mataanabucar/EXV-rev-7/2026-09-24-EX-MA-simplified/2026-09-24-cut-list.md

# EX-MA control box, pedestal and sandbox — cut list

All parts 12 mm plywood (1/2in also works; hole positions are measured from the panel's lower-left corner as seen from the named side). Sizes in mm, rounded to 0.5.

## control-box

| Part | Qty | Length × width × thick | Notes |
|---|---|---|---|
| box floor | 1 | 405.0 × 250.0 × 12.0 |  |
| box front | 1 | 405.0 × 218.0 × 12.0 |  |
| box rear | 1 | 405.0 × 218.0 × 12.0 |  |
| box right side | 1 | 226.0 × 218.0 × 12.0 |  |
| box left side | 1 | 226.0 × 218.0 × 12.0 |  |
| box top (removable) | 1 | 405.0 × 250.0 × 12.0 | screwed to the sides, front and rear; lift off for service |
| axle bearing block left | 1 | 100.0 × 60.0 × 12.0 | screwed to the floor from below (2 x #6) |
| axle bearing block right | 1 | 100.0 × 60.0 × 12.0 | screwed to the floor from below (2 x #6) |

**box floor** — holes / slots

| Feature | Size | Position (a, b) | Purpose |
|---|---|---|---|
| hole | Ø8.5 | (113.0, 100.0) along (u, v) | slew spool axle (nut + washer in a Ø22 x 7 counterbore from below) |

**box front** — holes / slots

| Feature | Size | Position (a, b) | Purpose |
|---|---|---|---|
| hole | Ø62.0 | (282.0, 80.0) along (v, z) | 2in conduit |
| hole | Ø4.6 | (322.0, 40.0) along (v, z) | fitting bolt (M3 × 35 through the sandbox wall) |
| hole | Ø4.6 | (322.0, 120.0) along (v, z) | fitting bolt (M3 × 35 through the sandbox wall) |
| hole | Ø4.6 | (242.0, 40.0) along (v, z) | fitting bolt (M3 × 35 through the sandbox wall) |
| hole | Ø4.6 | (242.0, 120.0) along (v, z) | fitting bolt (M3 × 35 through the sandbox wall) |
| hole | Ø4.6 | (25.0, 25.0) along (v, z) | box-to-sandbox bolt (M3 × 30) |
| hole | Ø4.6 | (380.0, 25.0) along (v, z) | box-to-sandbox bolt (M3 × 30) |

**box top (removable)** — holes / slots

| Feature | Size | Position (a, b) | Purpose |
|---|---|---|---|
| hole | Ø24.4 | (113.0, 100.0) along (u, v) | spool tube bearing |
| slot | 133.0 × 9.0 slot (along u) | (93.0, 360.0) along (u, v) | boom lever slot = hard stop (42 deg swing) |
| slot | 128.7 × 9.0 slot (along u) | (93.0, 290.0) along (u, v) | stick lever slot = hard stop (41 deg swing) |
| slot | 123.9 × 9.0 slot (along u) | (93.0, 220.0) along (u, v) | bucket lever slot = hard stop (40 deg swing) |

**axle bearing block left** — holes / slots

| Feature | Size | Position (a, b) | Purpose |
|---|---|---|---|
| hole | Ø8.5 | (30.0, 70.0) along (u, z) | 5/16in lever axle |

**axle bearing block right** — holes / slots

| Feature | Size | Position (a, b) | Purpose |
|---|---|---|---|
| hole | Ø8.5 | (30.0, 70.0) along (u, z) | 5/16in lever axle |

## pedestal

| Part | Qty | Length × width × thick | Notes |
|---|---|---|---|
| pedestal top | 1 | 200.0 × 180.0 × 12.0 |  |
| pedestal wall -u (conduit) | 1 | 180.0 × 178.0 × 12.0 |  |
| pedestal wall +u (removable access) | 1 | 180.0 × 178.0 × 12.0 | screwed on; remove to reach the slew drum clamp and the elbow |
| pedestal wall -v | 1 | 178.0 × 176.0 × 12.0 |  |
| pedestal wall +v | 1 | 178.0 × 176.0 × 12.0 |  |
| pedestal shelf | 1 | 156.0 × 148.0 × 12.0 | rests on the two cleats; carries the PEX bushing just above the slew drum |
| pedestal shelf cleat -v | 1 | 148.0 × 12.0 × 12.0 |  |
| pedestal shelf cleat +v | 1 | 148.0 × 12.0 × 12.0 |  |

**pedestal top** — holes / slots

| Feature | Size | Position (a, b) | Purpose |
|---|---|---|---|
| hole | Ø26.2 | (110.0, 90.0) along (u, v) | PEX turret tube clearance |
| hole | Ø3.0 | (136.9, 116.9) along (u, v) | pilot, #8 screw from the base |
| hole | Ø3.0 | (83.1, 116.9) along (u, v) | pilot, #8 screw from the base |
| hole | Ø3.0 | (83.1, 63.1) along (u, v) | pilot, #8 screw from the base |
| hole | Ø3.0 | (136.9, 63.1) along (u, v) | pilot, #8 screw from the base |

**pedestal wall -u (conduit)** — holes / slots

| Feature | Size | Position (a, b) | Purpose |
|---|---|---|---|
| hole | Ø62.0 | (82.0, 80.0) along (v, z) | 2in conduit |
| hole | Ø4.6 | (42.0, 40.0) along (v, z) | fitting bolt (M3 × 25) |
| hole | Ø4.6 | (42.0, 120.0) along (v, z) | fitting bolt (M3 × 25) |
| hole | Ø4.6 | (122.0, 40.0) along (v, z) | fitting bolt (M3 × 25) |
| hole | Ø4.6 | (122.0, 120.0) along (v, z) | fitting bolt (M3 × 25) |

**pedestal shelf** — holes / slots

| Feature | Size | Position (a, b) | Purpose |
|---|---|---|---|
| hole | Ø30.4 | (70.0, 78.0) along (u, v) | slew-tube-bushing |

## sandbox

| Part | Qty | Length × width × thick | Notes |
|---|---|---|---|
| sandbox floor | 1 | 610.0 × 610.0 × 12.0 | the pedestal and the elbow support screw to it |
| sandbox wall -u (box side) | 1 | 610.0 × 230.0 × 12.0 |  |
| sandbox wall +u | 1 | 610.0 × 230.0 × 12.0 |  |
| sandbox wall -v | 1 | 586.0 × 230.0 × 12.0 |  |
| sandbox wall +v | 1 | 586.0 × 230.0 × 12.0 |  |

**sandbox wall -u (box side)** — holes / slots

| Feature | Size | Position (a, b) | Purpose |
|---|---|---|---|
| hole | Ø62.0 | (297.0, 80.0) along (v, z) | 2in conduit (seal with silicone) |
| hole | Ø4.6 | (337.0, 40.0) along (v, z) | bolt from the control box |
| hole | Ø4.6 | (337.0, 120.0) along (v, z) | bolt from the control box |
| hole | Ø4.6 | (257.0, 40.0) along (v, z) | bolt from the control box |
| hole | Ø4.6 | (257.0, 120.0) along (v, z) | bolt from the control box |
| hole | Ø4.6 | (40.0, 25.0) along (v, z) | bolt from the control box |
| hole | Ø4.6 | (395.0, 25.0) along (v, z) | bolt from the control box |

## Other cut stock

- 2in sch 40 PVC conduit: 141 mm (socket floor to socket floor).
- 5/16in rod: lever axle 205 mm; slew spool axle 274 mm.
- 5/16in rod lever handles: 3 × 230 mm.
- 8-32 rod (joint pins only): 2 × 42 mm, 2 × 22 mm, 1 × 65 mm.
