mataanabucar/EXV-rev-7/2026-09-24-EX-MA-simplified/Preview/2026-09-24-b5-control-box.png

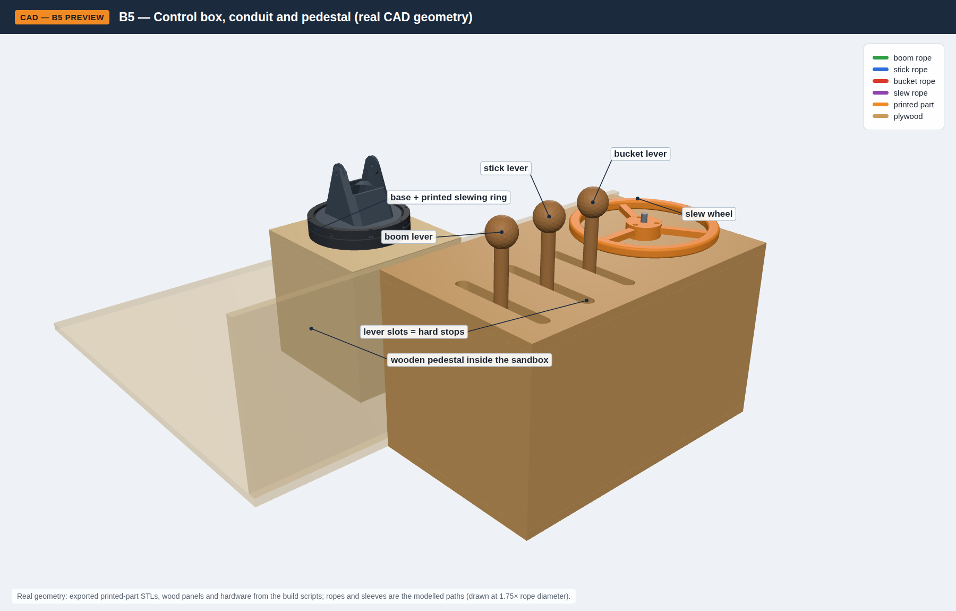
2026-09-24-EX-MA-simplified/Preview/2026-09-24-b5-control-box.png
