mataanabucar/EXV-rev-7/2026-09-24-EX-MA-simplified/Preview/2026-09-24-concept-05-arm-cutaway.png

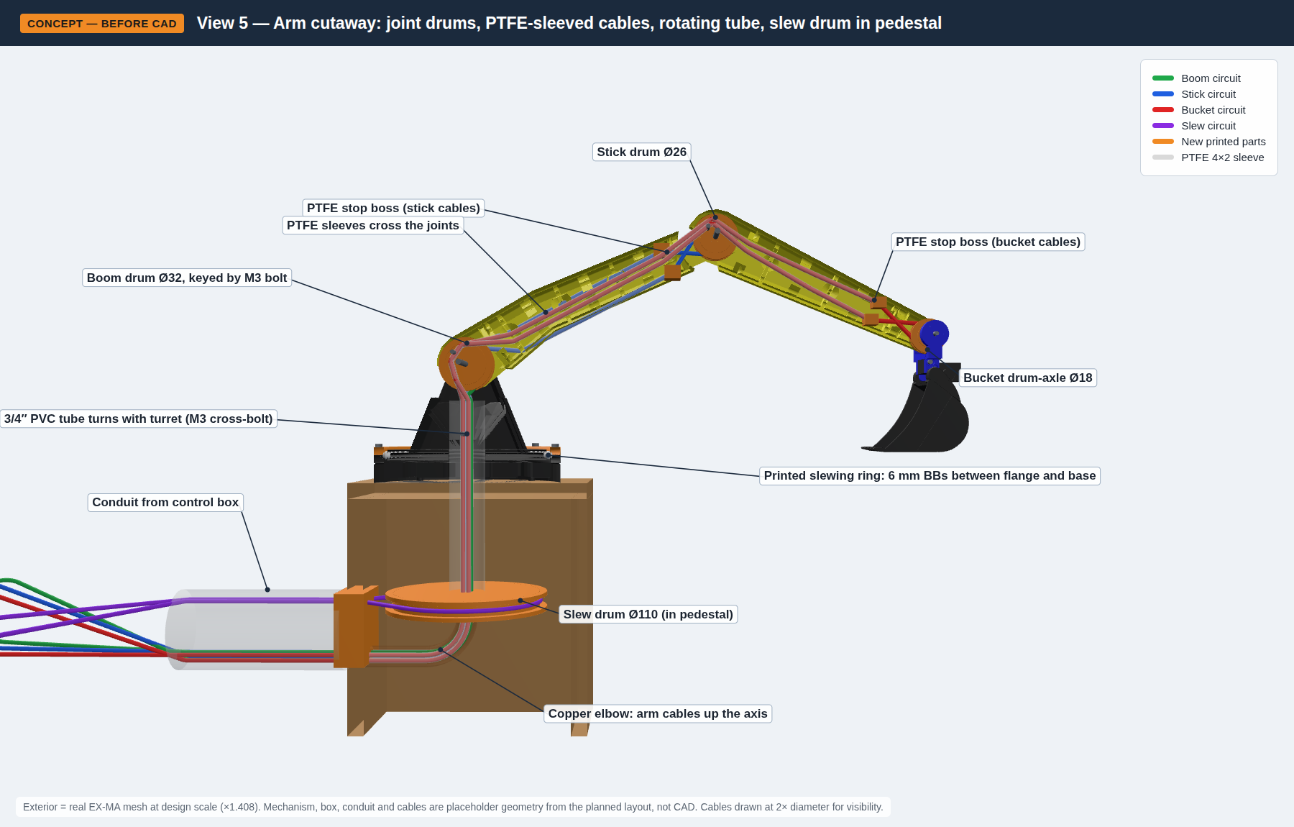
2026-09-24-EX-MA-simplified/Preview/2026-09-24-concept-05-arm-cutaway.png
