mataanabucar/EXV-rev-7/2026-09-24-EX-MA-simplified/Preview/2026-09-24-concept-06-slew-bearing-detail.png

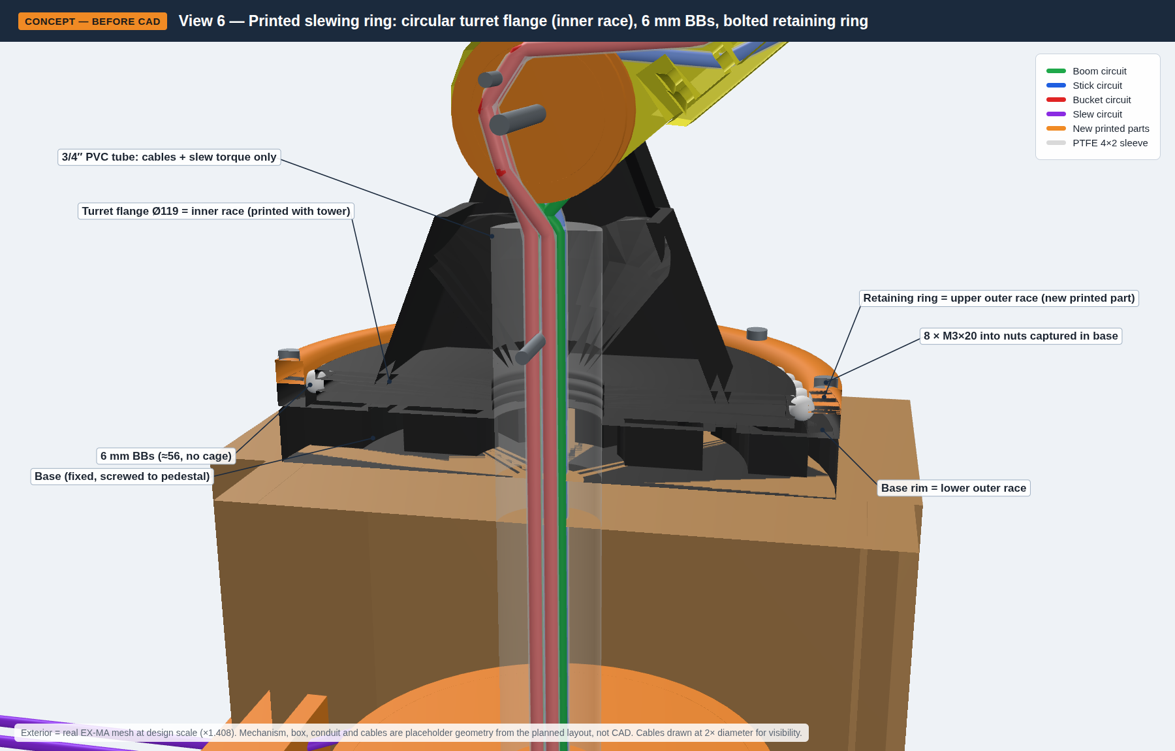
2026-09-24-EX-MA-simplified/Preview/2026-09-24-concept-06-slew-bearing-detail.png
