mataanabucar/EXV-rev-7/2026-09-24-EX-MA-simplified/Preview/2026-09-24-view2-full-system-cutaway.png

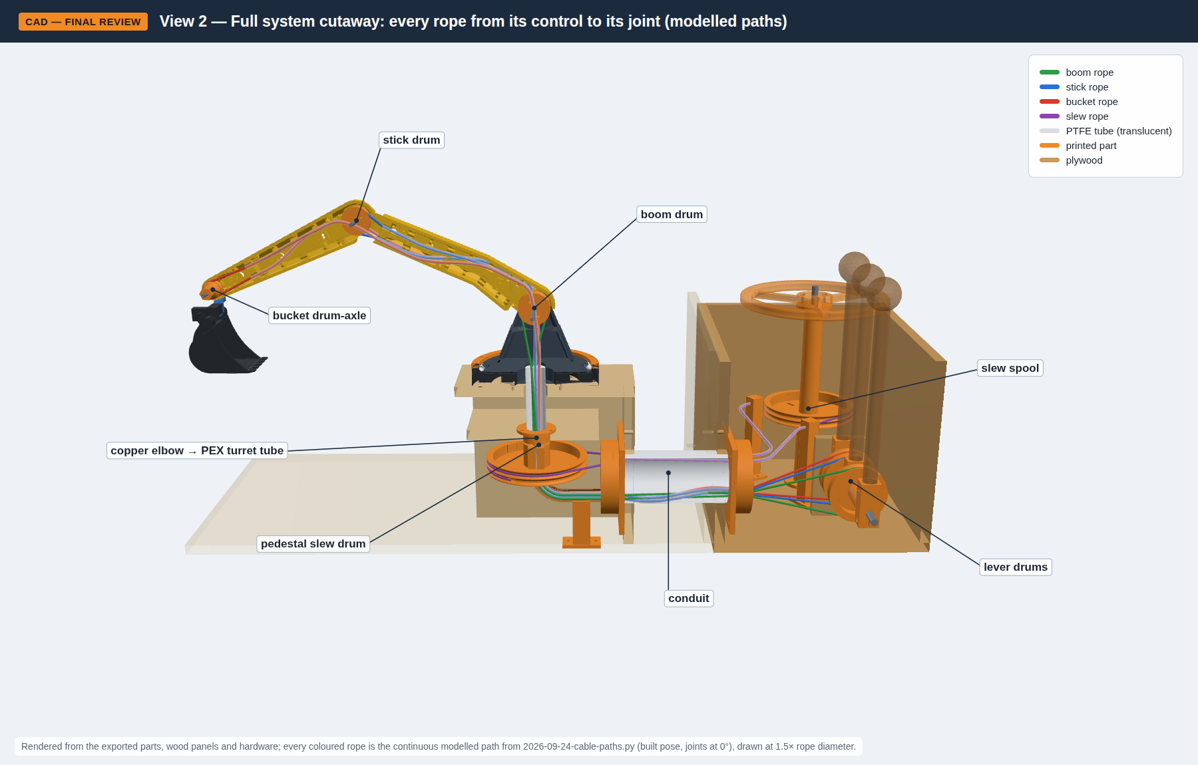
2026-09-24-EX-MA-simplified/Preview/2026-09-24-view2-full-system-cutaway.png
