mataanabucar/EXV-rev-7/2026-09-24-EX-MA-simplified/Preview/2026-09-24-view4-boom-joint.png

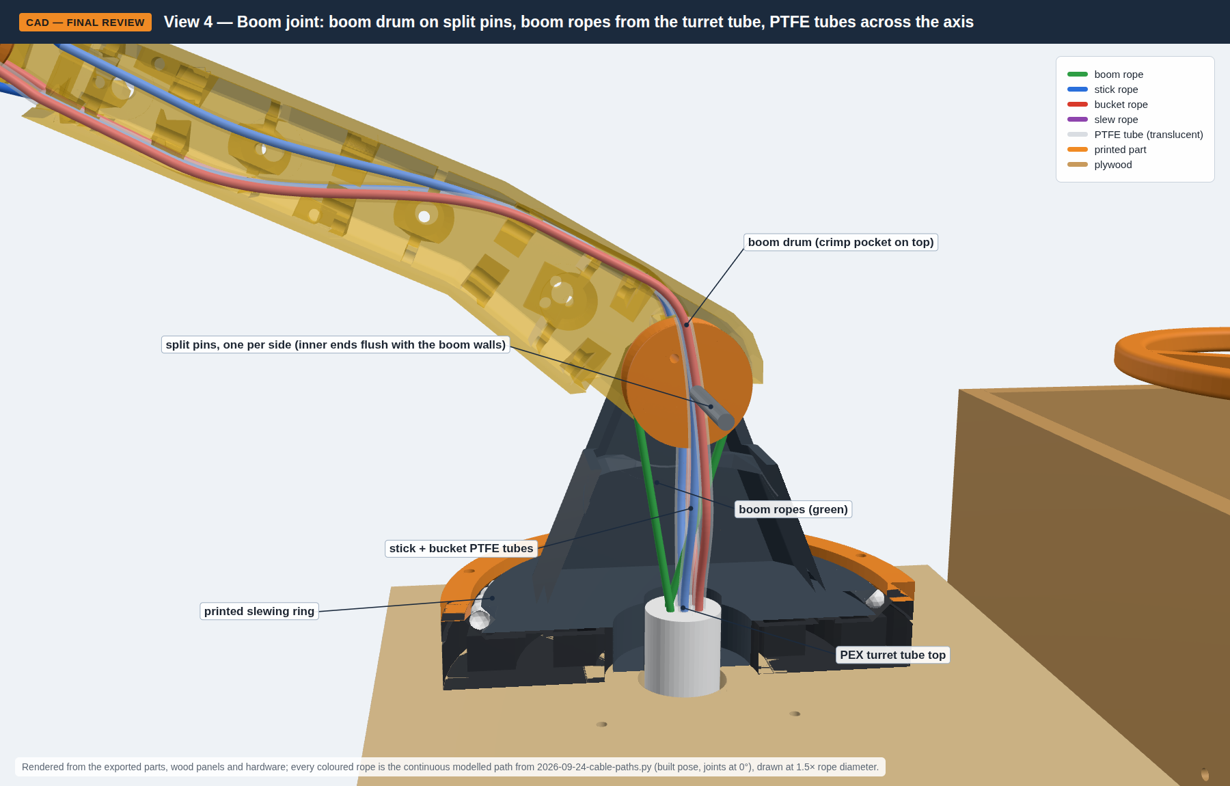
2026-09-24-EX-MA-simplified/Preview/2026-09-24-view4-boom-joint.png
