mataanabucar/EXV-rev-7/2026-09-24-EX-MA-simplified/Preview/2026-09-25-stick-nose-before-after.png

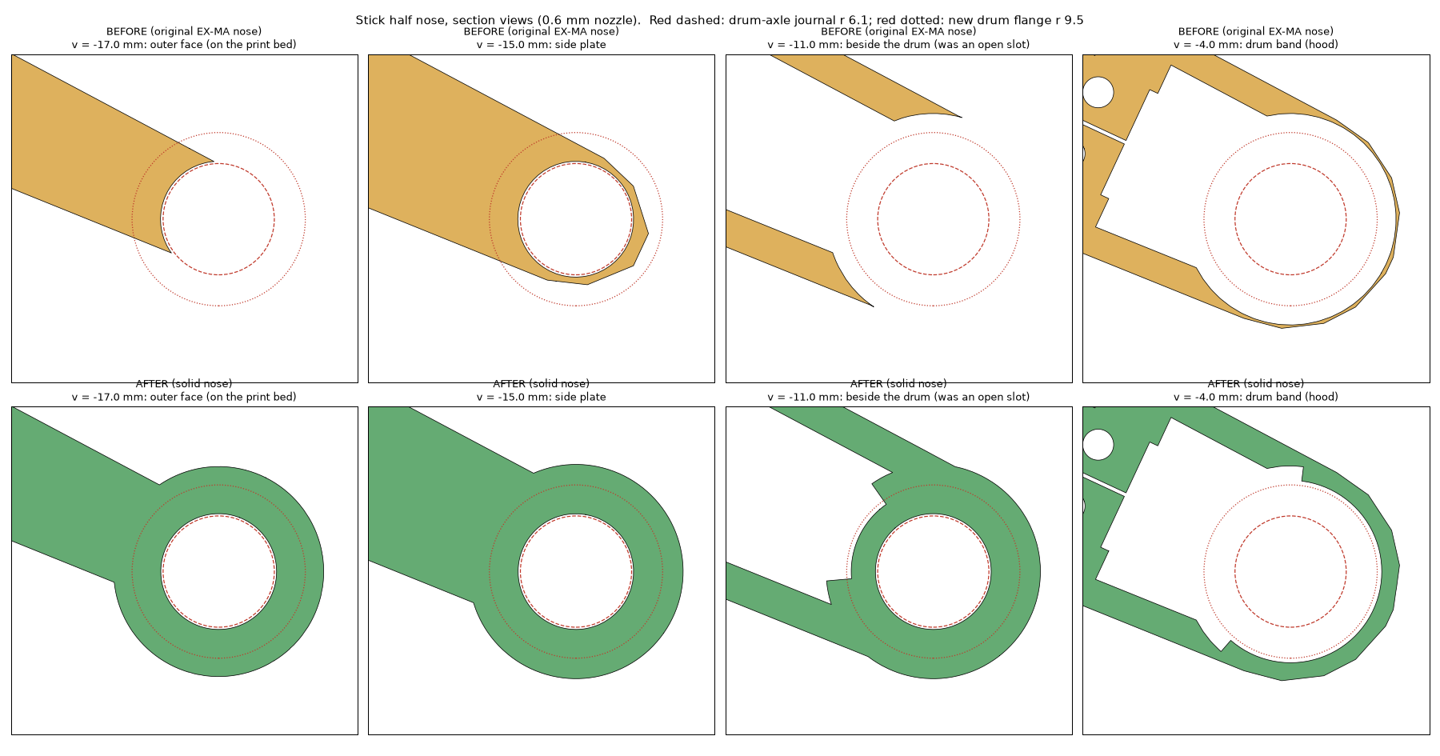
2026-09-24-EX-MA-simplified/Preview/2026-09-25-stick-nose-before-after.png
