mataanabucar/EXV-rev-7/References/ARM image.png

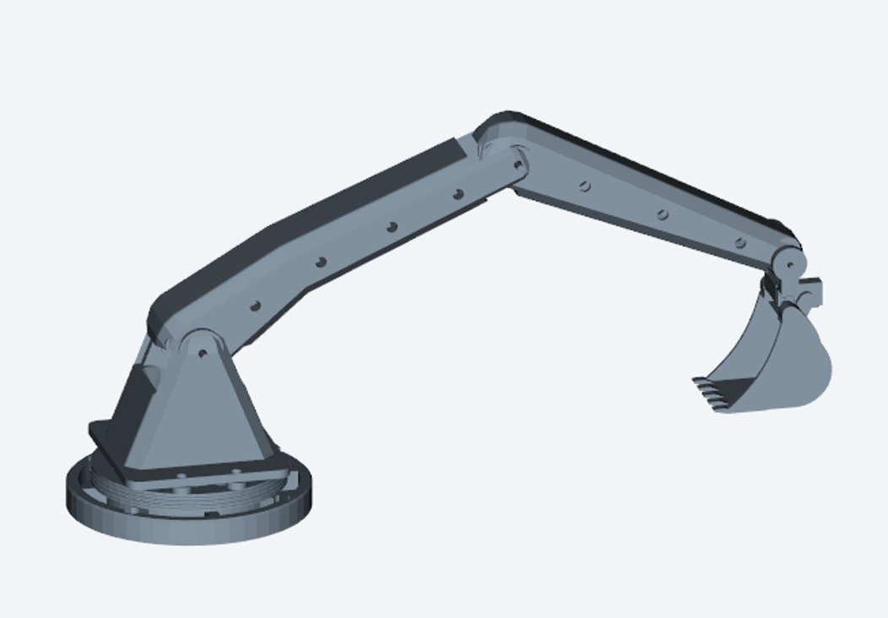
References/ARM image.png
