mataanabucar/EXV-rev-7/References/image-gen-2.png

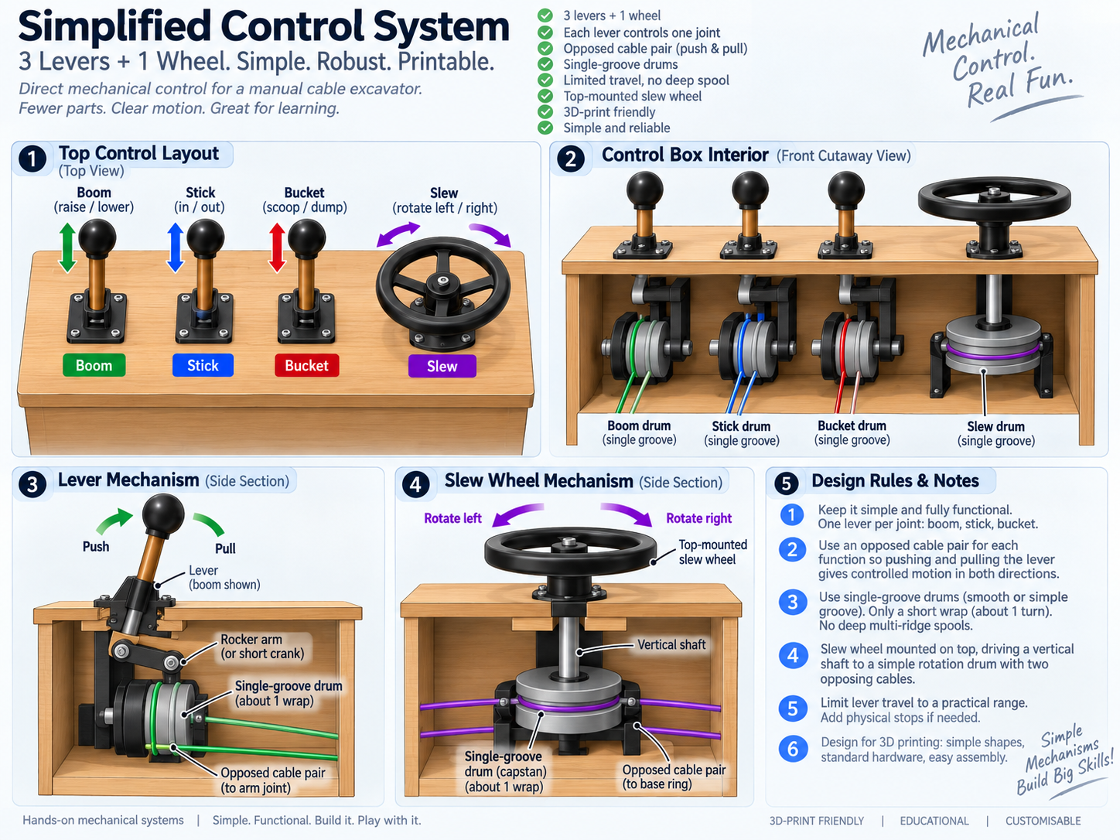
References/image-gen-2.png
