mataanabucar/EXV-rev-7/References/IMG_2449.jpeg

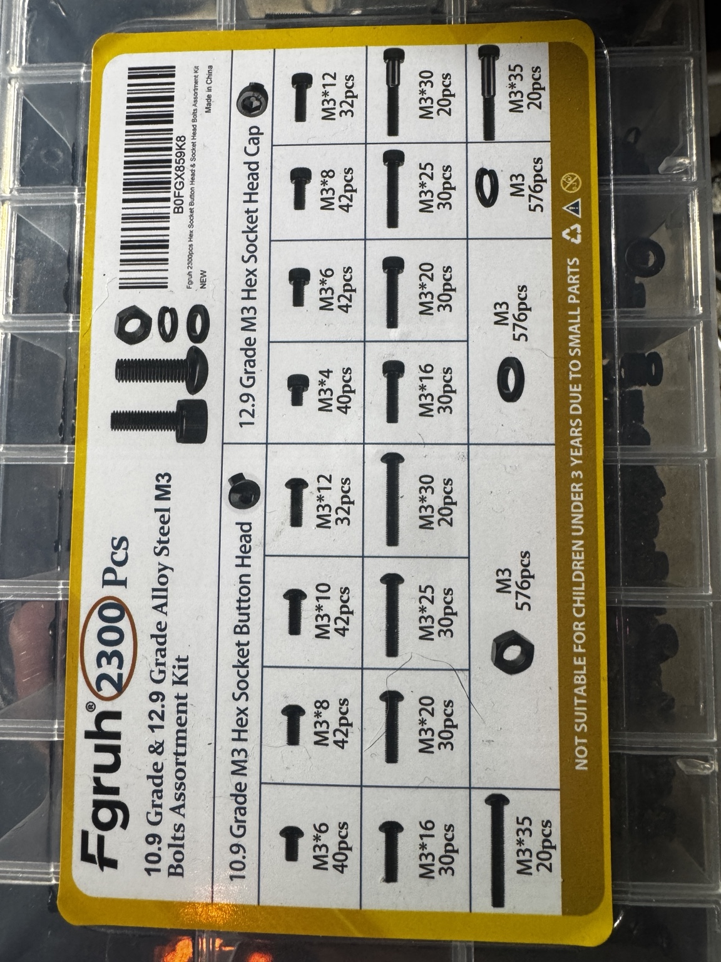
References/IMG_2449.jpeg
