mataanabucar/EXV-rev-7/References/IMG_2454.jpeg

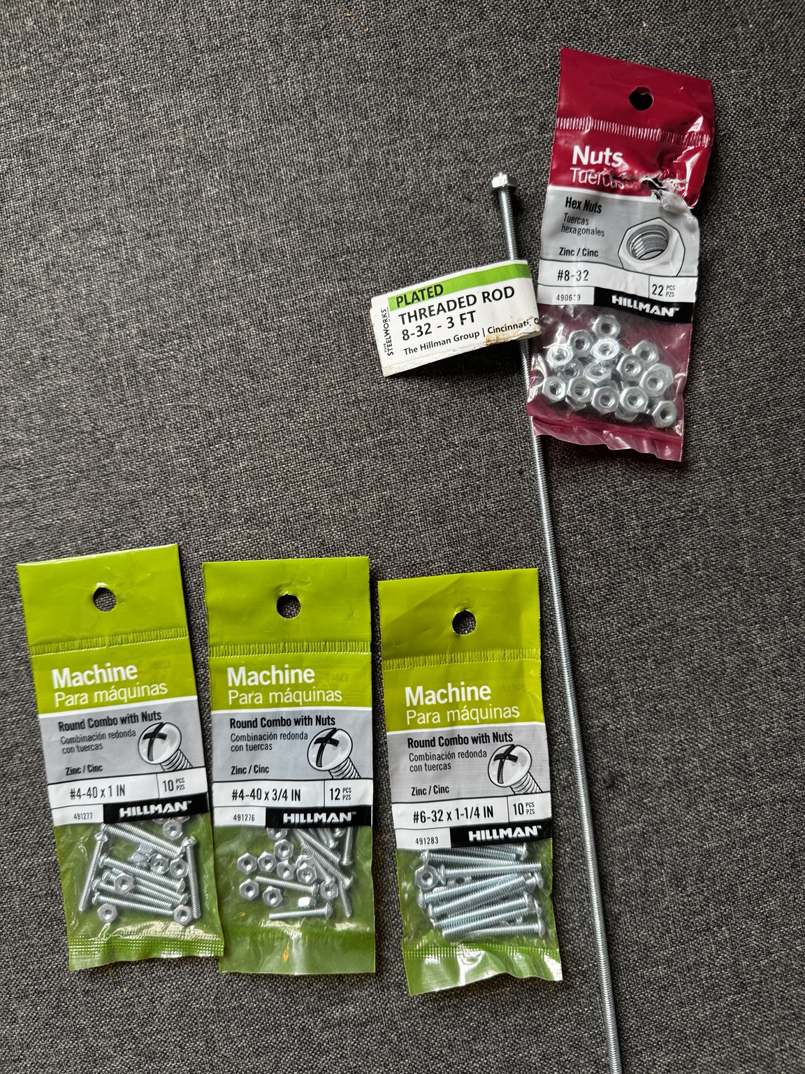
References/IMG_2454.jpeg
