mataanabucar/EXV-rev-7/References/ref image 3.png

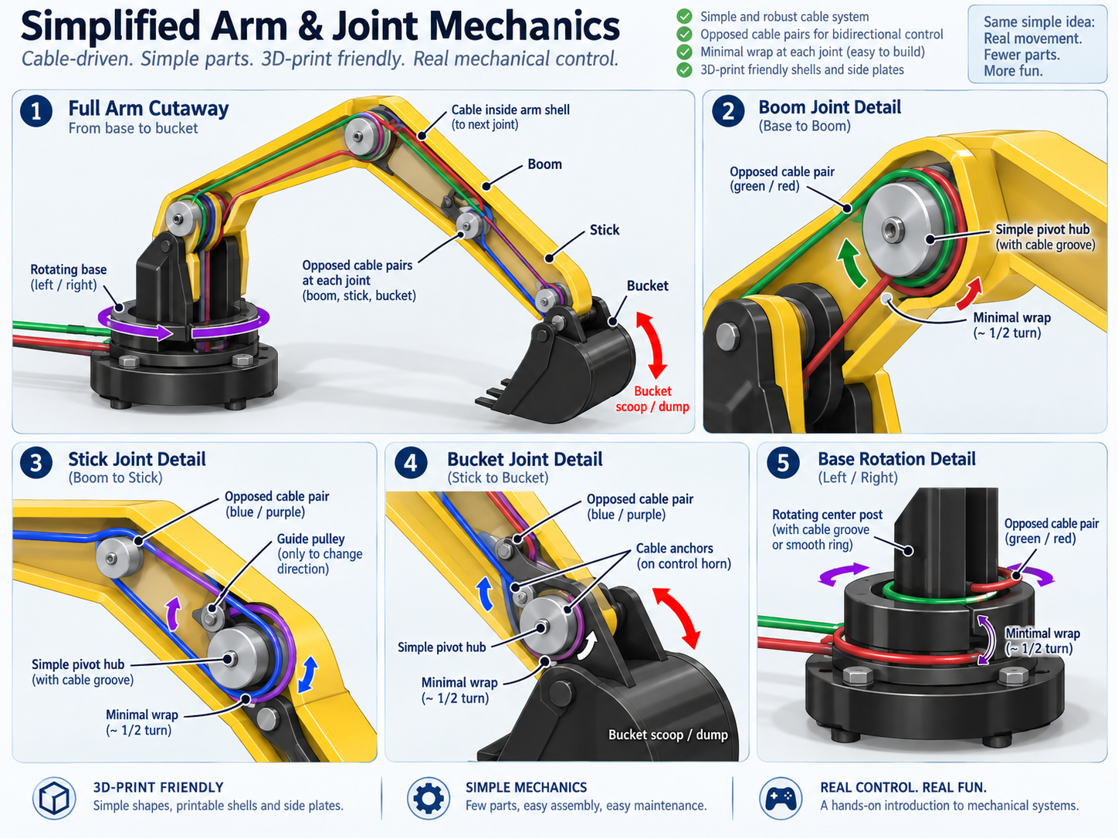
References/ref image 3.png
