mataanabucar/EXV-rev-7/References/ref image 4(1).png

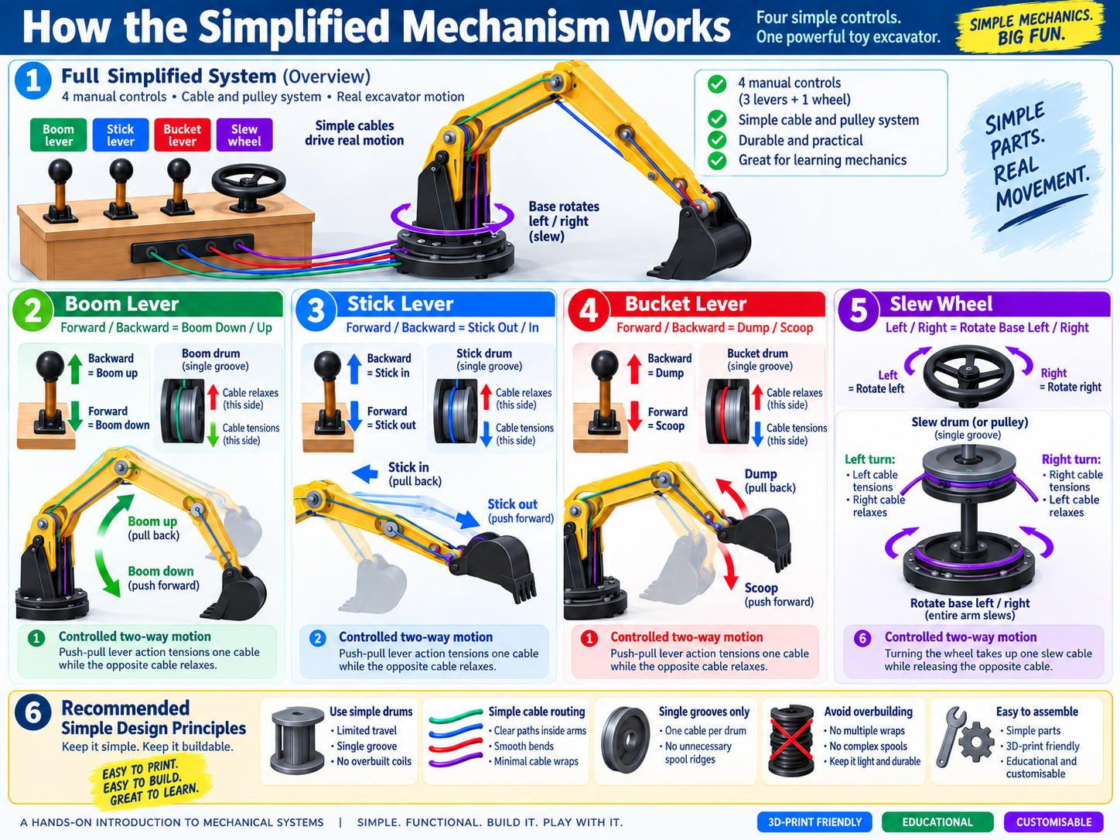
References/ref image 4(1).png
