mataanabucar/EXV-rev-7/References/ref image 5.png

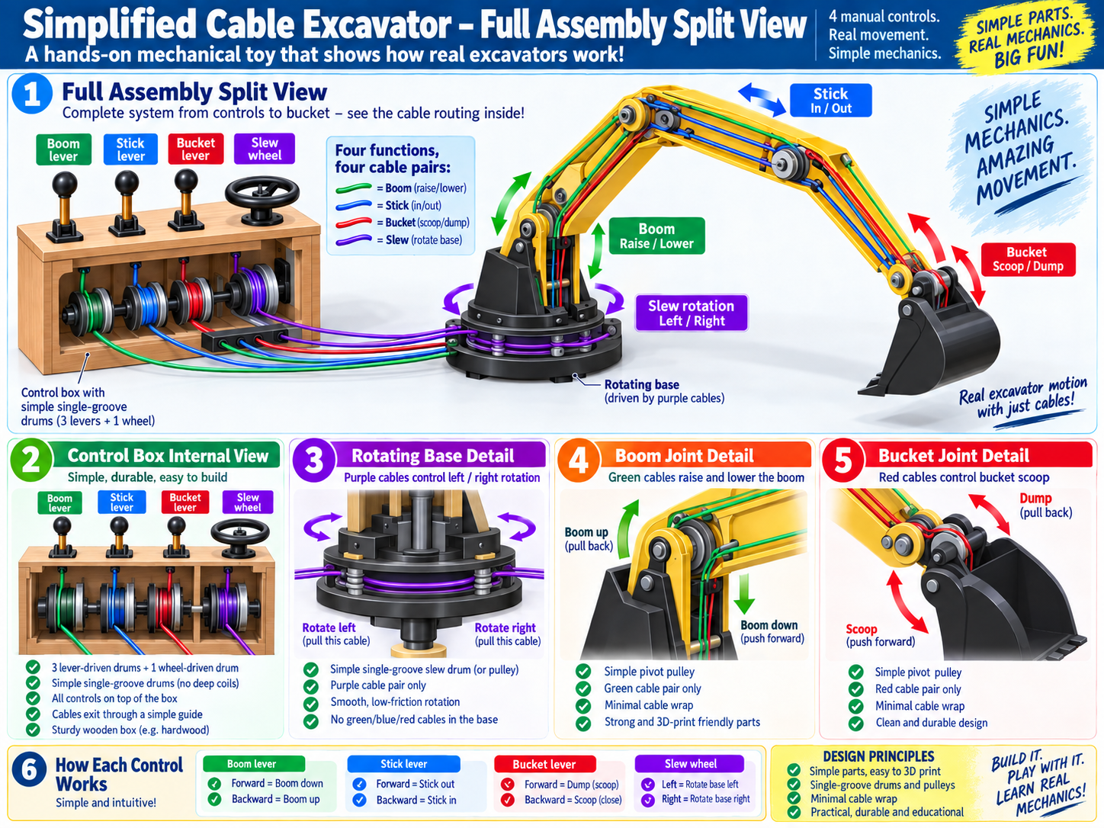
References/ref image 5.png
