mataanabucar/EXV-rev-7/2026-09-24-EX-MA-simplified/STEP/2026-09-24-ex-ma-assembly.step

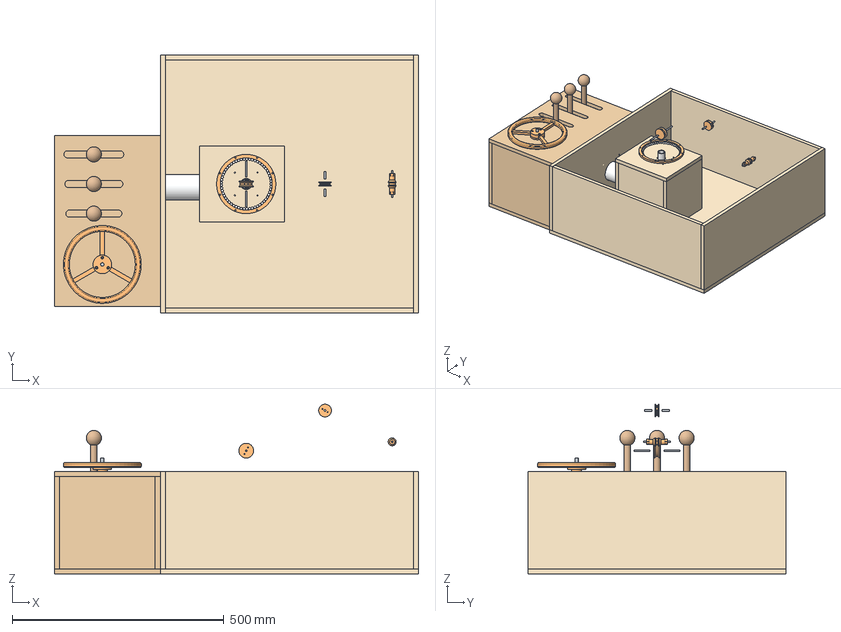
[picture p25: CAD file, 2026-09-25]
2026-09-24-EX-MA-simplified/STEP/2026-09-24-ex-ma-assembly.step
860.0 x 610.0 x 401.0 mm
boom-drum
stick-drum
bucket-drum-axle
slew-drum
slewing-ring-retaining-ring
conduit-end-fitting-box
conduit-end-fitting-pedestal
lever-hub-boom
lever-hub-stick
lever-hub-bucket
slew-spool
slew-wheel
spool-riser
slew-tube-post-A
slew-tube-post-B
slew-tube-bushing
elbow-support
box-floor
box-front
box-rear
box-right-side
box-left-side
box-top-removable
axle-bearing-block-left
axle-bearing-block-right
pedestal-top
pedestal-wall--u-conduit
pedestal-wall-+u-removable-access
pedestal-wall--v
pedestal-wall-+v
pedestal-shelf
pedestal-shelf-cleat--v
pedestal-shelf-cleat-+v
sandbox-floor
sandbox-wall--u-box-side
sandbox-wall-+u
sandbox-wall--v
sandbox-wall-+v
lever-axle-5_16in-rod
slew-spool-axle-5_16in-rod
boom-handle-(5_8in-dowel-+-knob)
stick-handle-(5_8in-dowel-+-knob)
bucket-handle-(5_8in-dowel-+-knob)
2in-PVC-conduit
3_4in-PEX-B-turret-tube
1_2in-copper-elbow-+-pipe
boom-split-pin-left-(8-32-rod)
boom-split-pin-right-(8-32-rod)
stick-split-pin-left-(8-32-rod)
stick-split-pin-right-(8-32-rod)
bucket-pin-(8-32-rod)
BB-01
BB-02
BB-03
BB-04
BB-05
BB-06
BB-07
BB-08
BB-09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
