mataanabucar/EXV-rev-7/2026-09-24-EX-MA-simplified/3MF/2026-09-27-orca-other-parts-plaplus.3mf

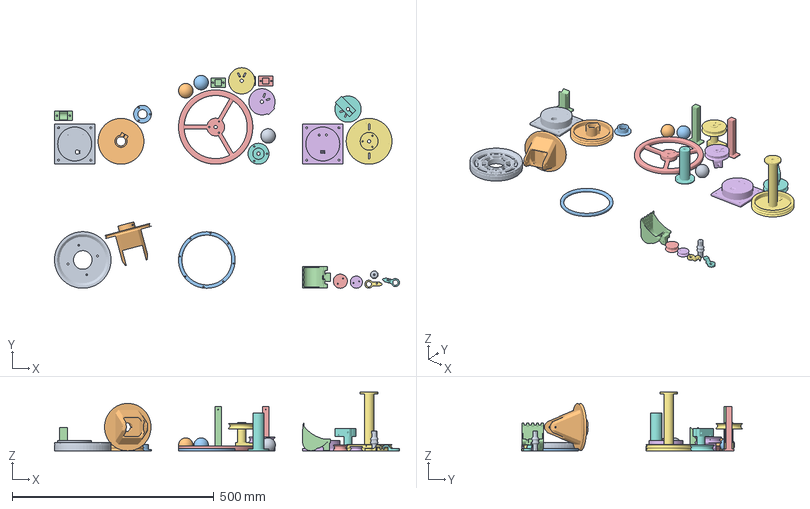
[picture p26: CAD file, 2026-09-28]
2026-09-24-EX-MA-simplified/3MF/2026-09-27-orca-other-parts-plaplus.3mf
854.3 x 546.1 x 145.0 mm
conduit-end-fitting-pedestal
slew-drum
slew-tube-bushing
elbow-support
slew-wheel
lever-hub-stick
lever-hub-boom
spool-riser
lever-knob-1
lever-knob-2
lever-knob-3
slew-tube-post-1
slew-tube-post-2
conduit-end-fitting-box
slew-spool
lever-hub-bucket
base
tower
slewing-ring-retaining-ring
bucket
boom-drum
stick-drum
bucket-ear-right
bucket-ear-left
bucket-drum-axle
