mataanabucar/EXV-rev-7/2026-09-24-EX-MA-simplified/STEP/2026-09-29-bucket-ear-left-cad.step

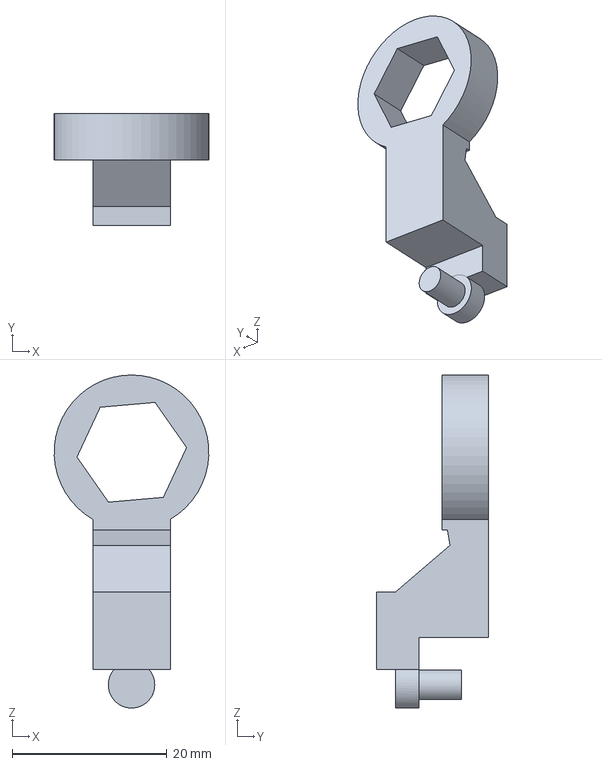
[picture p27: CAD file, 2026-09-29]
2026-09-24-EX-MA-simplified/STEP/2026-09-29-bucket-ear-left-cad.step
19.9 x 14.5 x 43.0 mm
