mataanabucar/EXV-rev-7/2026-09-24-EX-MA-simplified/STL/2026-09-24-boom-half-left.stl

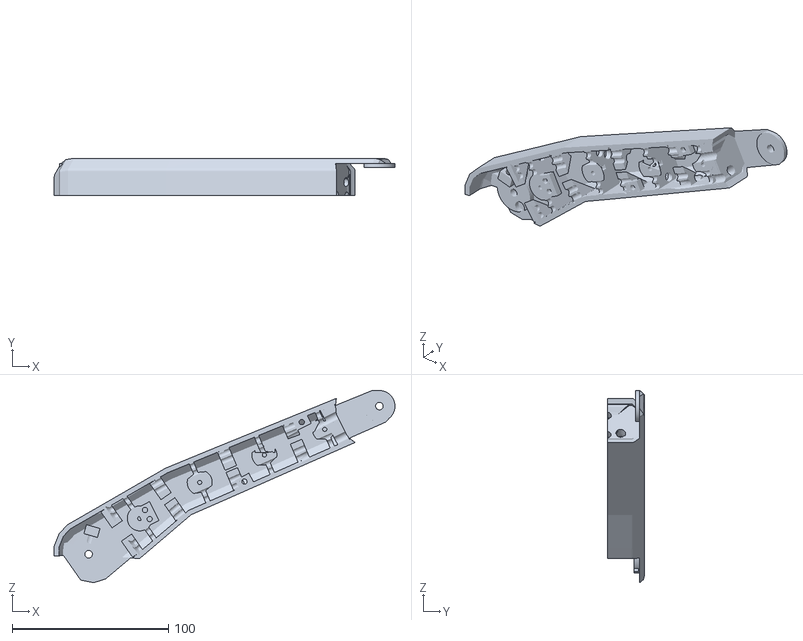
[picture p28: CAD file, 2026-09-25]
2026-09-24-EX-MA-simplified/STL/2026-09-24-boom-half-left.stl
218.4 x 24.0 x 123.2
