mataanabucar/EXV-rev-7/References/EX-MA Colored ARM.stl

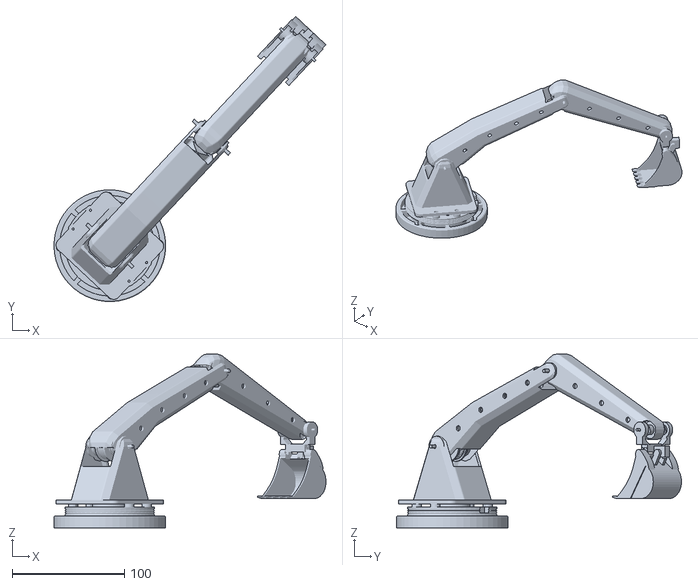
[picture p29: CAD file, 2026-09-24]
References/EX-MA Colored ARM.stl
242.2 x 253.7 x 154.8
