mataanabucar/EXV-rev-7/2026-09-24-EX-MA-simplified/STL/2026-09-24-bucket-ear-left.stl

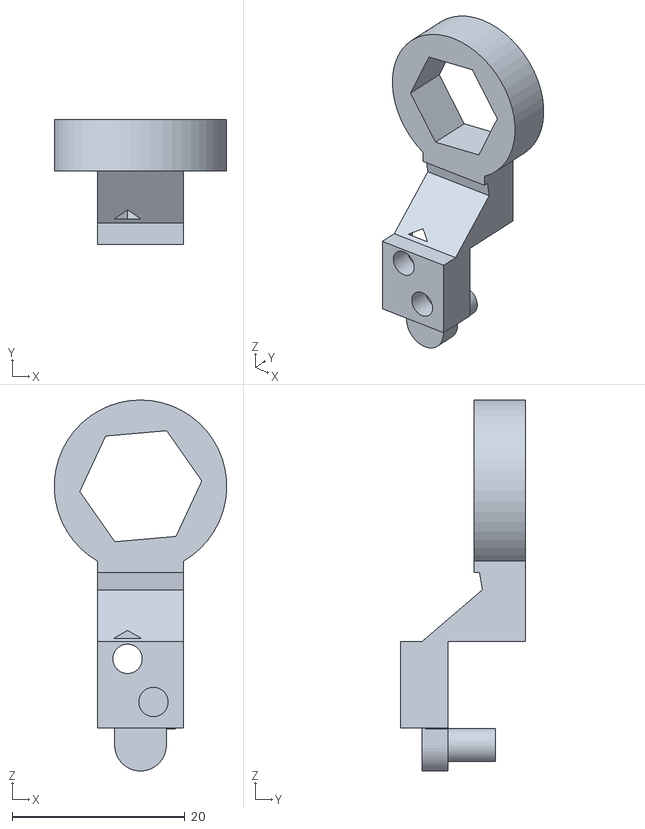
[picture p30: CAD file, 2026-09-25]
2026-09-24-EX-MA-simplified/STL/2026-09-24-bucket-ear-left.stl
20.0 x 14.5 x 43.0
