mataanabucar/EXV-rev-7/2026-09-24-EX-MA-simplified/3MF/2026-09-27-orca-arm-shell-petg.3mf

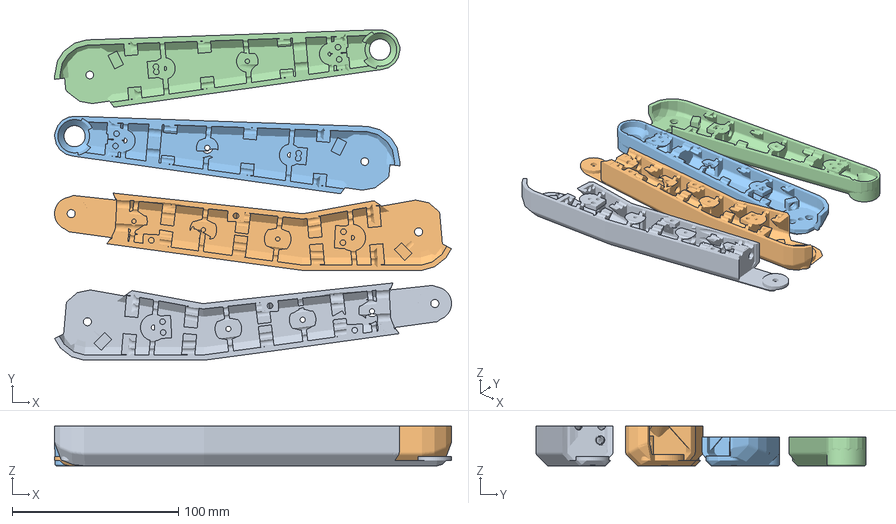
[picture p31: CAD file, 2026-09-27]
2026-09-24-EX-MA-simplified/3MF/2026-09-27-orca-arm-shell-petg.3mf
238.5 x 198.5 x 24.0 mm
boom-half-right
boom-half-left
stick-half-right
stick-half-left
