mataanabucar/EXV-rev-7/2026-09-24-EX-MA-simplified/STEP/2026-09-29-slewing-ring-retaining-ring.step

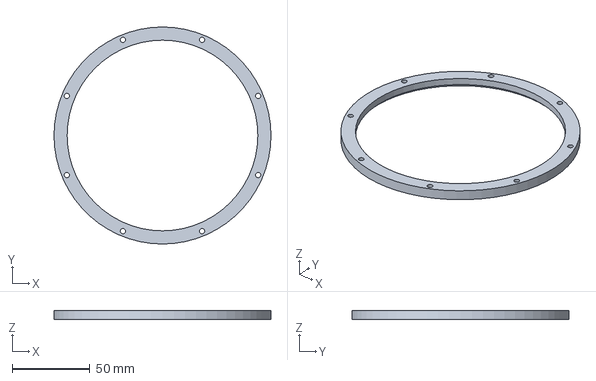
[picture p32: CAD file, 2026-09-29]
2026-09-24-EX-MA-simplified/STEP/2026-09-29-slewing-ring-retaining-ring.step
140.0 x 140.0 x 6.00 mm
