mataanabucar/EXV-rev-7/2026-09-24-EX-MA-simplified/STL/2026-09-24-stick-half-right.stl

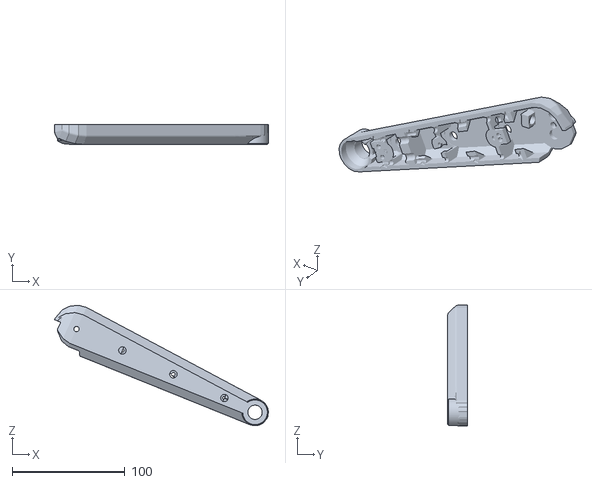
[picture p33: CAD file, 2026-09-25]
2026-09-24-EX-MA-simplified/STL/2026-09-24-stick-half-right.stl
190.1 x 17.5 x 107.1
