mataanabucar/EXV-rev-7/References/Source_Bucket_Repaired.step

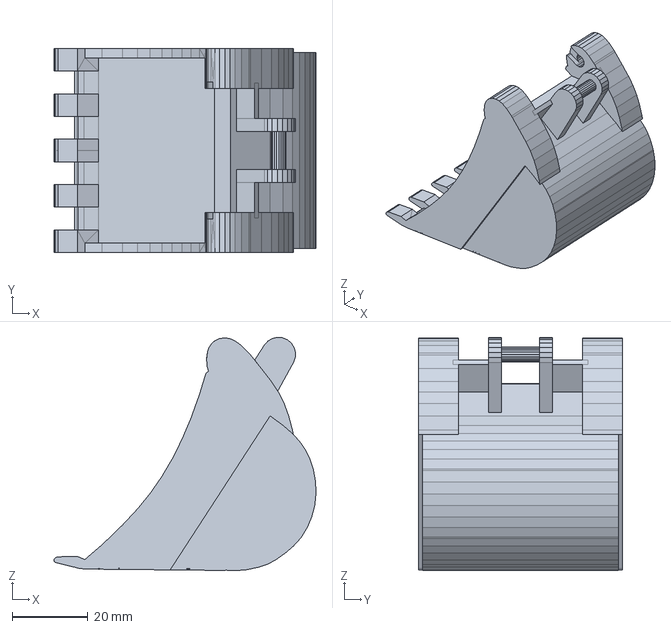
[picture p34: CAD file, 2026-09-24]
References/Source_Bucket_Repaired.step
69.3 x 54.0 x 61.7 mm
