mataanabucar/EXV-rev-7/2026-09-24-EX-MA-simplified/STEP/2026-09-29-base.step

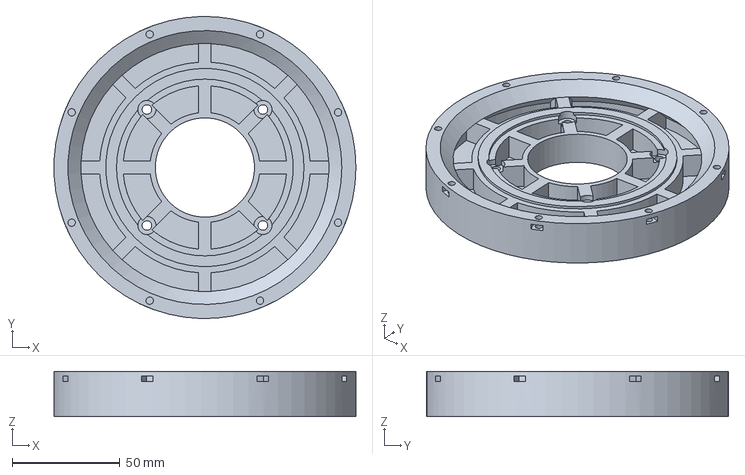
[picture p35: CAD file, 2026-09-29]
2026-09-24-EX-MA-simplified/STEP/2026-09-29-base.step
139.9 x 140.0 x 21.0 mm
