mataanabucar/EXV-rev-7/2026-09-24-EX-MA-simplified/STL/2026-09-24-boom-half-right.stl

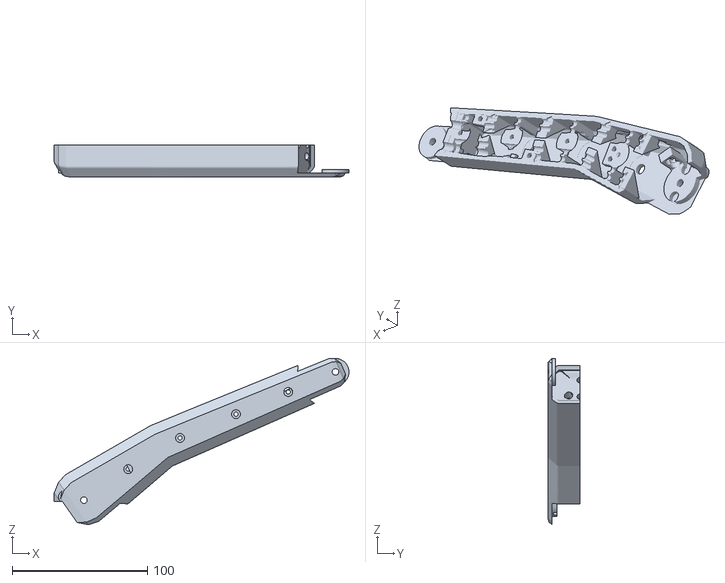
[picture p37: CAD file, 2026-09-25]
2026-09-24-EX-MA-simplified/STL/2026-09-24-boom-half-right.stl
218.4 x 24.0 x 123.2
