mataanabucar/EXV-rev-7/2026-09-24-EX-MA-simplified/STL/2026-09-24-bucket-ear-right.stl

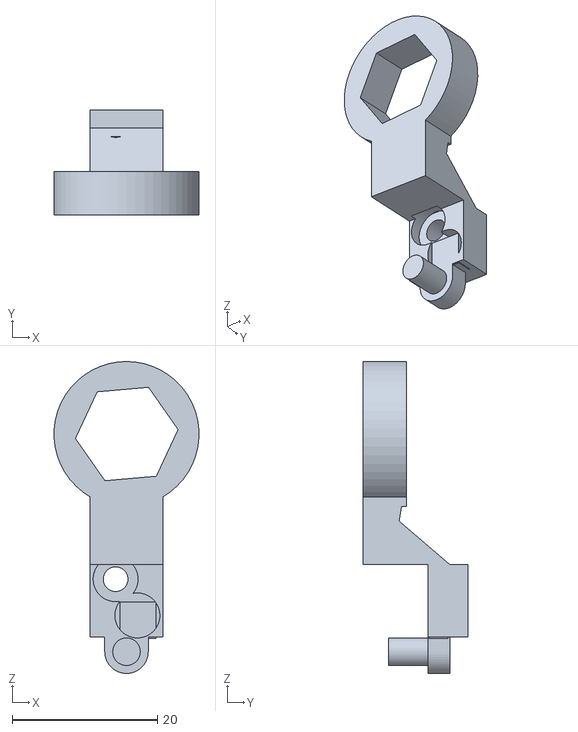
[picture p38: CAD file, 2026-09-25]
2026-09-24-EX-MA-simplified/STL/2026-09-24-bucket-ear-right.stl
20.0 x 14.5 x 43.0
