mataanabucar/EXV-rev-7/2026-09-24-EX-MA-simplified/STEP/2026-09-24-lever-hub-bucket.step

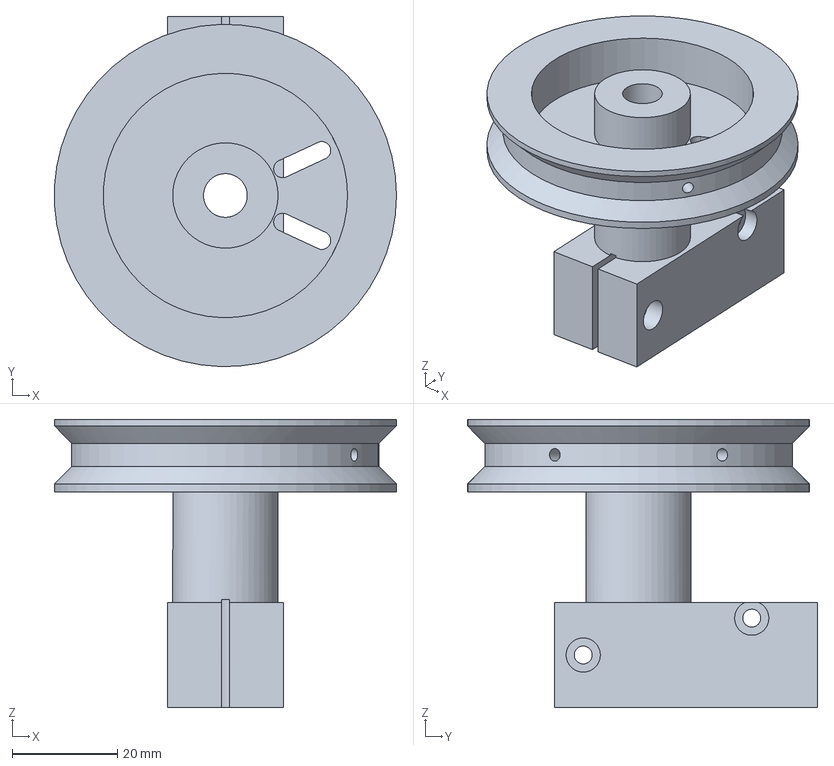
[picture p39: CAD file, 2026-09-25]
2026-09-24-EX-MA-simplified/STEP/2026-09-24-lever-hub-bucket.step
64.9 x 66.5 x 54.8 mm
