mataanabucar/EXV-rev-7/2026-09-24-EX-MA-simplified/STL/2026-09-24-bucket.stl

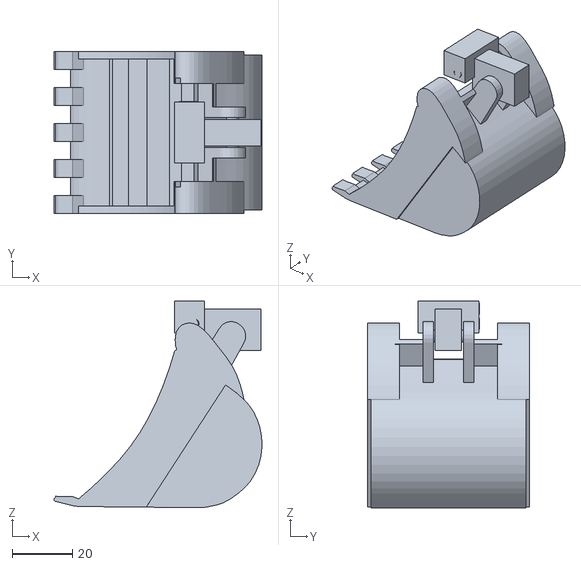
[picture p40: CAD file, 2026-09-25]
2026-09-24-EX-MA-simplified/STL/2026-09-24-bucket.stl
69.3 x 54.0 x 68.8
