mataanabucar/EXV-rev-7/2026-09-24-EX-MA-simplified/STEP/2026-09-24-lever-knob.step

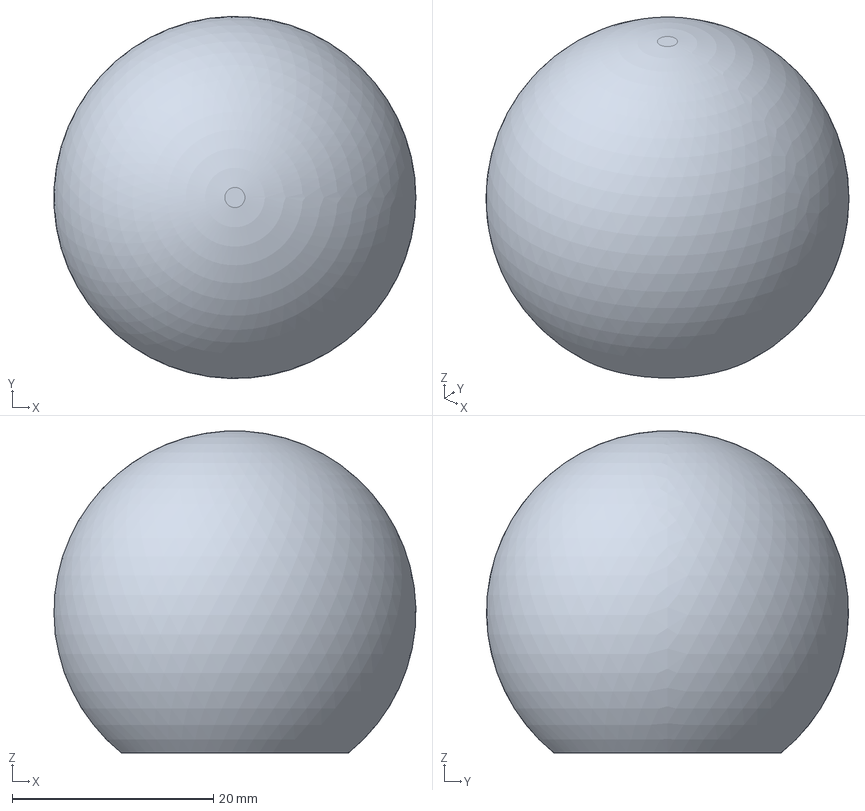
[picture p41: CAD file, 2026-09-25]
2026-09-24-EX-MA-simplified/STEP/2026-09-24-lever-knob.step
36.0 x 36.0 x 32.0 mm
