mataanabucar/EXV-rev-7/2026-09-24-EX-MA-simplified/STL/2026-09-24-tower.stl

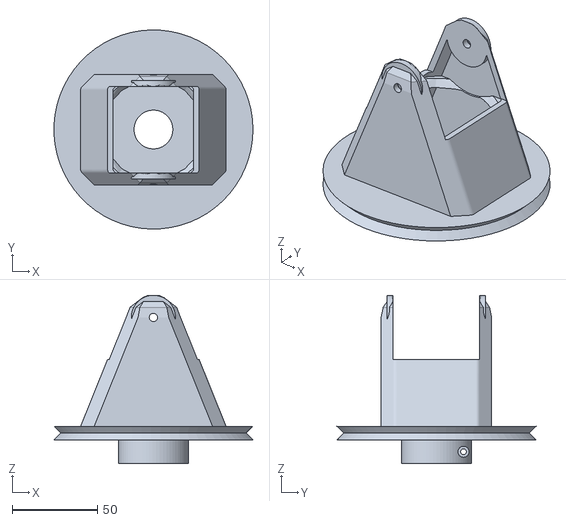
[picture p42: CAD file, 2026-09-24]
2026-09-24-EX-MA-simplified/STL/2026-09-24-tower.stl
117.0 x 117.1 x 99.0
