mataanabucar/EXV-rev-7/2026-09-24-EX-MA-simplified/STEP/2026-09-24-control-box-wood.step

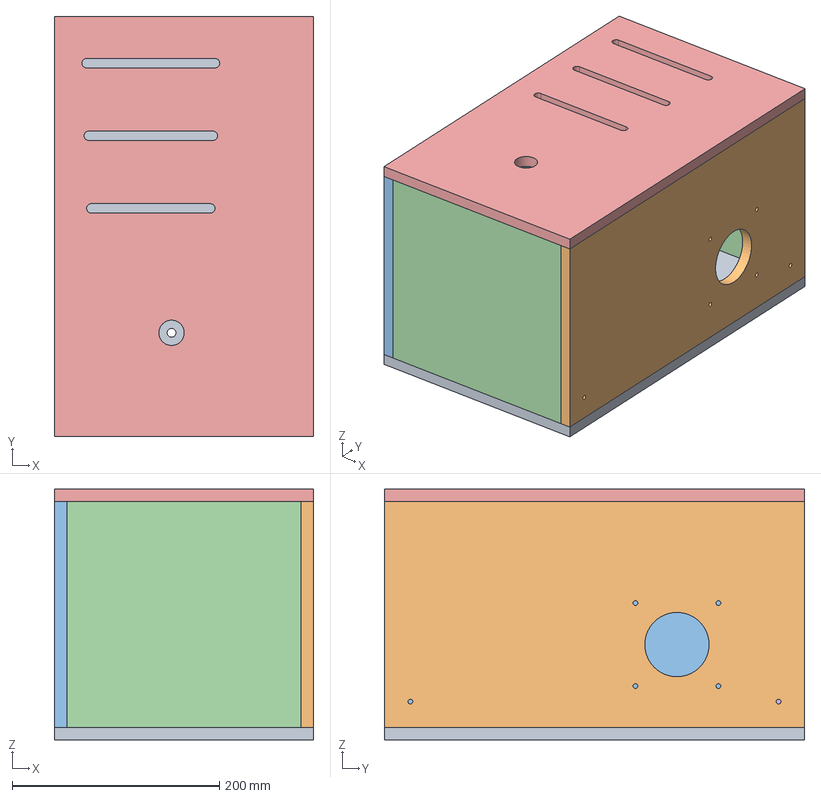
[picture p43: CAD file, 2026-09-25]
2026-09-24-EX-MA-simplified/STEP/2026-09-24-control-box-wood.step
250.0 x 405.0 x 242.0 mm
