mataanabucar/EXV-rev-7/2026-09-24-EX-MA-simplified/STL/2026-09-24-base.stl

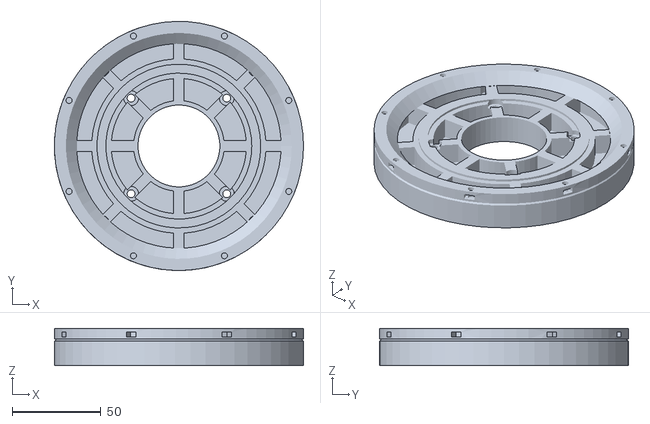
[picture p44: CAD file, 2026-09-24]
2026-09-24-EX-MA-simplified/STL/2026-09-24-base.stl
139.9 x 140.0 x 21.0
