mataanabucar/EXV-rev-7/2026-09-24-EX-MA-simplified/STEP/2026-09-24-lever-hub-stick.step

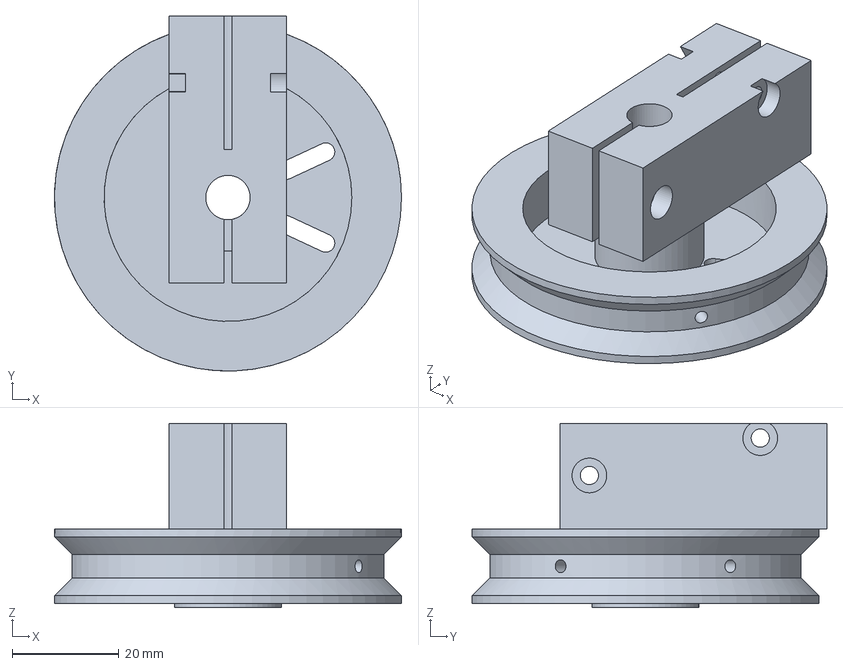
[picture p45: CAD file, 2026-09-25]
2026-09-24-EX-MA-simplified/STEP/2026-09-24-lever-hub-stick.step
65.0 x 66.5 x 34.5 mm
