mataanabucar/EXV-rev-7/2026-09-24-EX-MA-simplified/STEP/2026-09-24-sandbox-wood.step

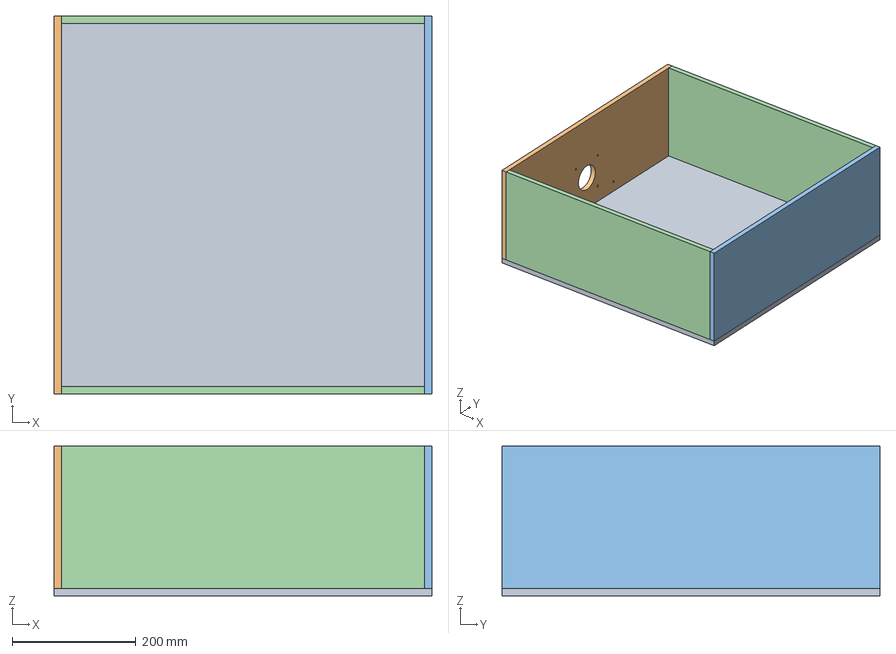
[picture p46: CAD file, 2026-09-25]
2026-09-24-EX-MA-simplified/STEP/2026-09-24-sandbox-wood.step
610.0 x 610.0 x 242.0 mm
