mataanabucar/EXV-rev-7/2026-09-24-EX-MA-simplified/STEP/2026-09-24-pedestal-wood.step

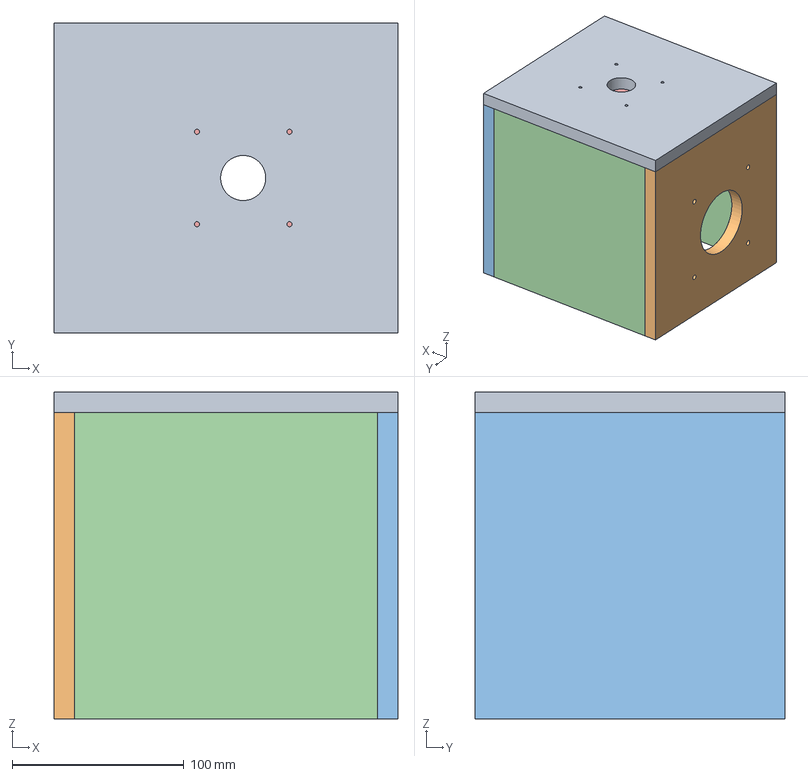
[picture p47: CAD file, 2026-09-25]
2026-09-24-EX-MA-simplified/STEP/2026-09-24-pedestal-wood.step
200.0 x 180.0 x 190.0 mm
