mataanabucar/EXV-rev-7/2026-09-24-EX-MA-simplified/STEP/2026-09-24-conduit-end-fitting-box.step

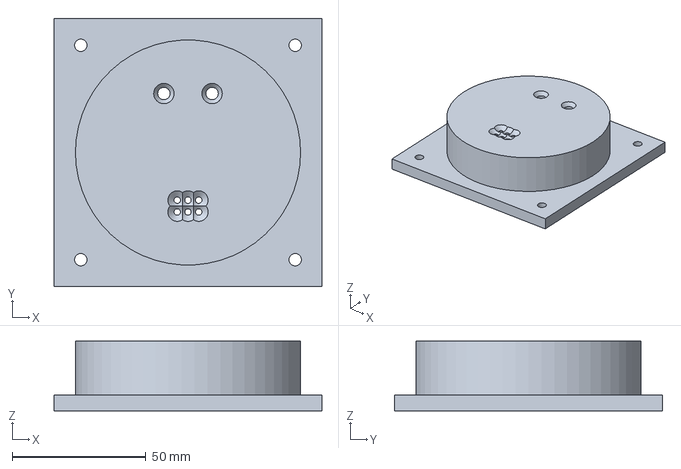
[picture p49: CAD file, 2026-09-25]
2026-09-24-EX-MA-simplified/STEP/2026-09-24-conduit-end-fitting-box.step
100.0 x 100.0 x 26.0 mm
