mataanabucar/EXV-rev-7/2026-09-24-EX-MA-simplified/STEP/2026-09-24-slew-spool.step

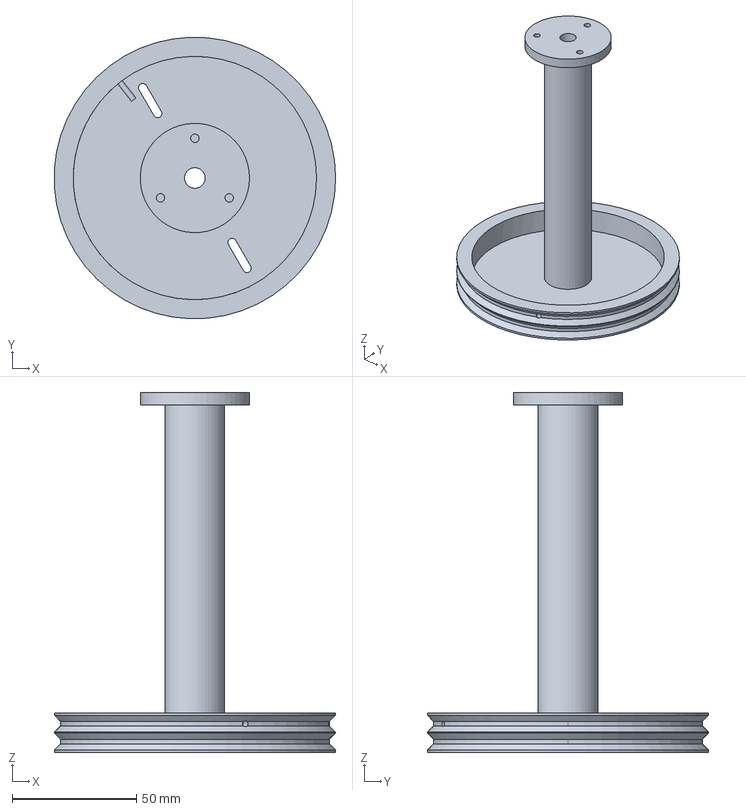
[picture p50: CAD file, 2026-09-25]
2026-09-24-EX-MA-simplified/STEP/2026-09-24-slew-spool.step
113.3 x 113.3 x 145.0 mm
