mataanabucar/EXV-rev-7/2026-09-24-EX-MA-simplified/STEP/2026-09-24-slew-tube-post.step

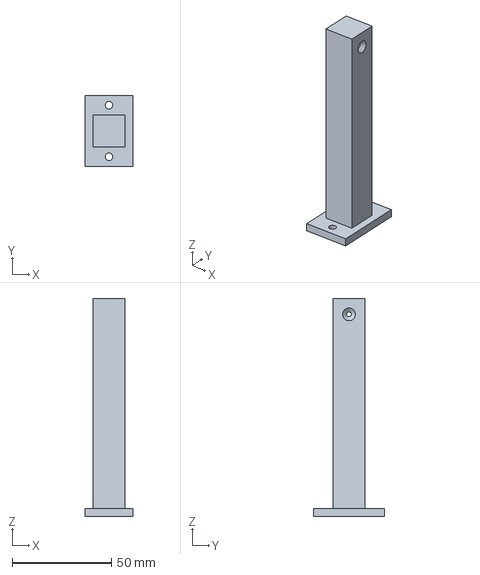
[picture p51: CAD file, 2026-09-25]
2026-09-24-EX-MA-simplified/STEP/2026-09-24-slew-tube-post.step
24.0 x 36.0 x 110.0 mm
