mataanabucar/EXV-rev-7/2026-09-24-EX-MA-simplified/STEP/2026-09-24-bucket-drum-axle.step

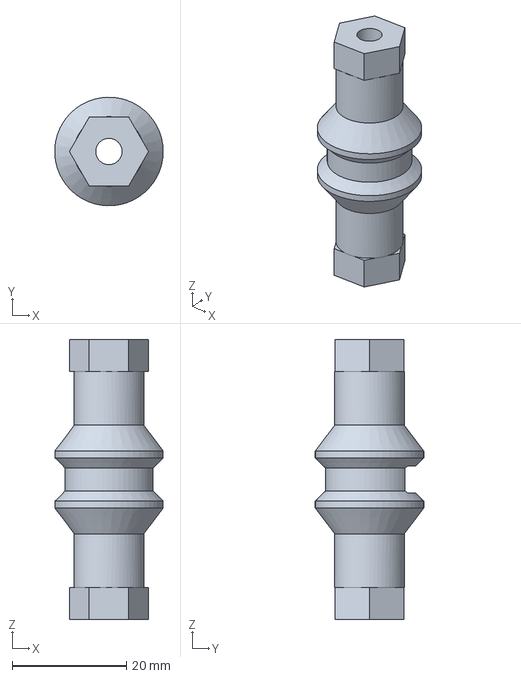
[picture p52: CAD file, 2026-09-25]
2026-09-24-EX-MA-simplified/STEP/2026-09-24-bucket-drum-axle.step
19.0 x 19.0 x 49.0 mm
