mataanabucar/EXV-rev-7/2026-09-24-EX-MA-simplified/STEP/2026-09-24-elbow-support.step

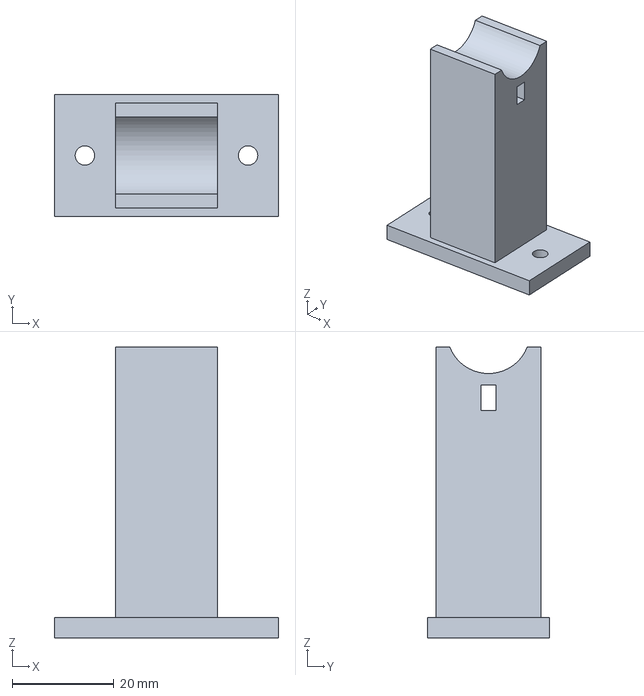
[picture p53: CAD file, 2026-09-25]
2026-09-24-EX-MA-simplified/STEP/2026-09-24-elbow-support.step
44.0 x 24.0 x 57.1 mm
