mataanabucar/EXV-rev-7/2026-09-24-EX-MA-simplified/STEP/2026-09-24-slew-drum.step

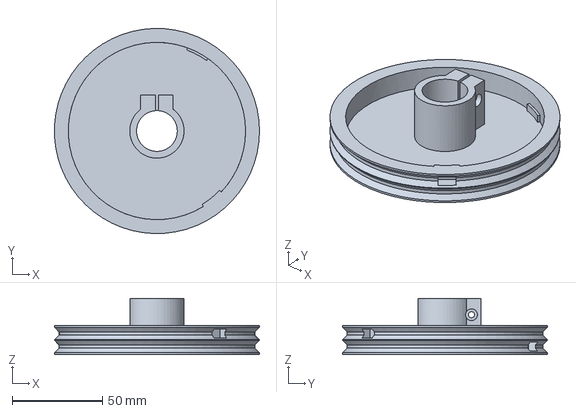
[picture p54: CAD file, 2026-09-25]
2026-09-24-EX-MA-simplified/STEP/2026-09-24-slew-drum.step
113.3 x 113.4 x 31.0 mm
