mataanabucar/EXV-rev-7/2026-09-24-EX-MA-simplified/STEP/2026-09-24-spool-riser.step

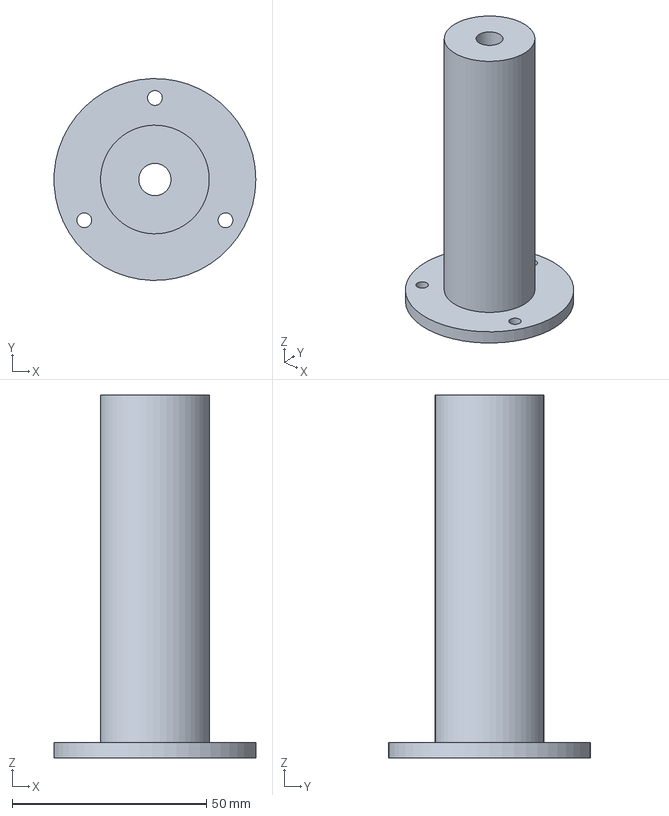
[picture p55: CAD file, 2026-09-25]
2026-09-24-EX-MA-simplified/STEP/2026-09-24-spool-riser.step
52.0 x 52.0 x 93.5 mm
