mataanabucar/EXV-rev-7/2026-09-24-EX-MA-simplified/STEP/2026-09-24-slew-tube-bushing.step

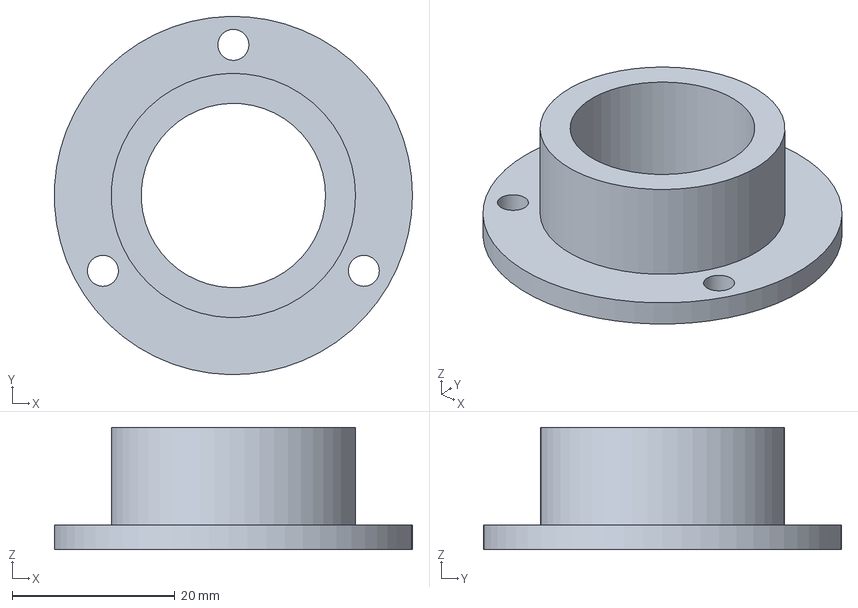
[picture p56: CAD file, 2026-09-25]
2026-09-24-EX-MA-simplified/STEP/2026-09-24-slew-tube-bushing.step
44.0 x 44.0 x 15.0 mm
