mataanabucar/EXV-rev-7/2026-09-24-EX-MA-simplified/STEP/2026-09-24-stick-drum.step

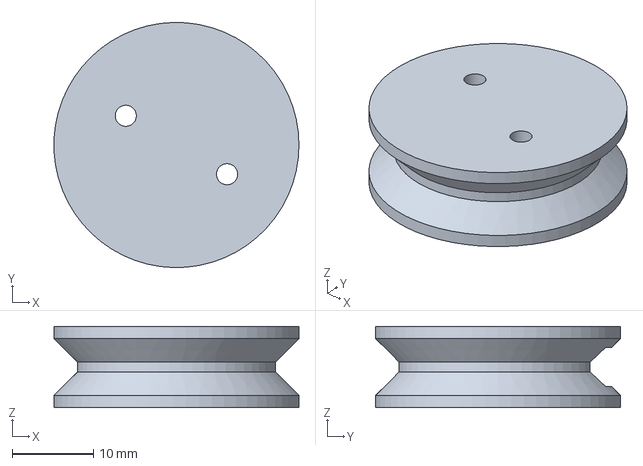
[picture p57: CAD file, 2026-09-25]
2026-09-24-EX-MA-simplified/STEP/2026-09-24-stick-drum.step
30.2 x 30.2 x 10.0 mm
