mataanabucar/EXV-rev-7/2026-09-24-EX-MA-simplified/STEP/2026-09-24-boom-drum.step

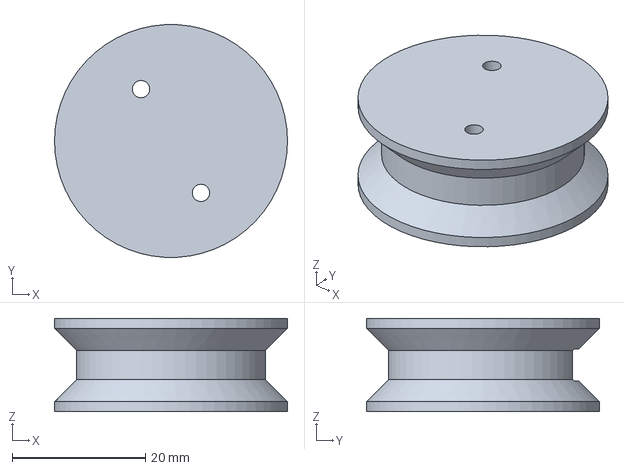
[picture p58: CAD file, 2026-09-25]
2026-09-24-EX-MA-simplified/STEP/2026-09-24-boom-drum.step
35.0 x 34.9 x 14.0 mm
