mataanabucar/EXV-rev-7/2026-09-24-EX-MA-simplified/STEP/2026-09-24-slew-wheel.step

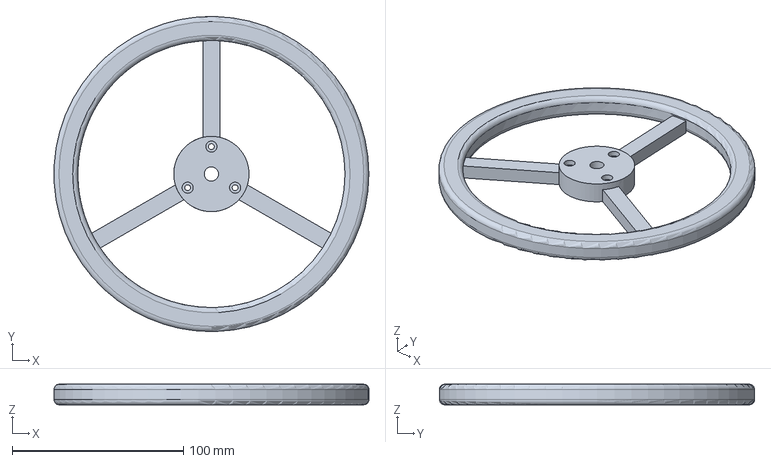
[picture p59: CAD file, 2026-09-25]
2026-09-24-EX-MA-simplified/STEP/2026-09-24-slew-wheel.step
183.9 x 184.0 x 12.0 mm
