mataanabucar/EXV-rev-7/(list of files, cad)

Other CAD files:
2026-09-24-EX-MA-simplified/3MF/2026-09-27-bambu-other-parts-plaplus.3mf
2026-09-24-EX-MA-simplified/STEP/2026-09-29-bucket-ear-right-cad.step
References/EX-MA Colored.3mf
2026-09-24-EX-MA-simplified/3MF/2026-09-27-bambu-arm-shell-petg.3mf
2026-09-24-EX-MA-simplified/STEP/2026-09-29-bucket-ear-right.step
2026-09-24-EX-MA-simplified/STEP/2026-09-29-bucket-ear-left.step
2026-09-24-EX-MA-simplified/STEP/2026-09-24-conduit-end-fitting-pedestal.step
2026-09-24-EX-MA-simplified/STEP/2026-09-24-slewing-ring-retaining-ring.step
2026-09-24-EX-MA-simplified/STL/2026-09-24-boom-drum.stl
2026-09-24-EX-MA-simplified/STL/2026-09-24-bucket-drum-axle.stl
2026-09-24-EX-MA-simplified/STL/2026-09-24-conduit-end-fitting-box.stl
2026-09-24-EX-MA-simplified/STL/2026-09-24-conduit-end-fitting-pedestal.stl
2026-09-24-EX-MA-simplified/STL/2026-09-24-elbow-support.stl
2026-09-24-EX-MA-simplified/STL/2026-09-24-lever-hub-boom.stl
2026-09-24-EX-MA-simplified/STL/2026-09-24-lever-hub-bucket.stl
2026-09-24-EX-MA-simplified/STL/2026-09-24-lever-hub-stick.stl
2026-09-24-EX-MA-simplified/STL/2026-09-24-lever-knob.stl
2026-09-24-EX-MA-simplified/STL/2026-09-24-slew-drum.stl
2026-09-24-EX-MA-simplified/STL/2026-09-24-slew-spool.stl
2026-09-24-EX-MA-simplified/STL/2026-09-24-slew-tube-bushing.stl
2026-09-24-EX-MA-simplified/STL/2026-09-24-slew-tube-post.stl
2026-09-24-EX-MA-simplified/STL/2026-09-24-slew-wheel.stl
2026-09-24-EX-MA-simplified/STL/2026-09-24-slewing-ring-retaining-ring.stl
2026-09-24-EX-MA-simplified/STL/2026-09-24-spool-riser.stl
2026-09-24-EX-MA-simplified/STL/2026-09-24-stick-drum.stl
2026-09-24-EX-MA-simplified/STL/2026-09-29-base.stl
2026-09-24-EX-MA-simplified/STL/2026-09-29-bucket-ear-left-cad.stl
2026-09-24-EX-MA-simplified/STL/2026-09-29-bucket-ear-left.stl
2026-09-24-EX-MA-simplified/STL/2026-09-29-bucket-ear-right-cad.stl
2026-09-24-EX-MA-simplified/STL/2026-09-29-bucket-ear-right.stl
2026-09-24-EX-MA-simplified/STL/2026-09-29-slewing-ring-retaining-ring.stl
