mataanabucar/EXV-rev-7/(commit log)

2026-09-24 Add pre-CAD concept images for simplified EX-MA mechanism and control box
    Five concept views (full assembly, control box, control box cutaway, arm,
    arm cutaway) rendered from the real EX-MA exterior mesh at design scale
    (x1.408) plus placeholder geometry for the planned mechanism: single-groove
    joint drums, PTFE-sleeved cables, rotating 3/4in PVC slew tube with the slew
    drum in a wooden pedestal, 2in PVC conduit, and a wooden control box with
    3 levers on a common 8-32 axle and a top-mounted slew wheel. No CAD/STL/STEP
    files are produced at this stage.
    Claude-Session: https://claude.ai/code/session_01FyTajvSx9qTWtyrkoopW9q
2026-09-24 Concept: remove green slew ring; turret rides on rotating PVC tube
    The green ring was the original slew drum. With the slew drum moved into the
    pedestal it has no job, so it is removed along with the base centre post and
    cap. The tower's centre boss is bored for the 3/4in PVC tube and cross-bolted
    to it; a 3/4in PVC slip coupling on a fender washer on the base floor carries
    the turret's weight. Concept images re-rendered.
    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
2026-09-24 Concept rev 2: circular turret flange, printed slewing ring, turret lowered 13 mm
    Replace the tower's square flange with a circular flange that forms the inner
    race of a printed ball slewing ring (6 mm BBs). The base rim is the lower
    outer race; a new bolted retaining ring (8 x M3) is the upper race and holds
    the turret down. The turret and arm drop 13 mm to close the gap left by the
    removed green ring. The PVC coupling/washer thrust idea is removed; the PVC
    tube now only carries cables and slew torque. Adds view 6, a slewing-ring
    detail cutaway, and re-renders views 1-5.
    Claude-Session: https://claude.ai/code/session_01FyTajvSx9qTWtyr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
2026-09-24 B1-B2: shared EX-MA frame/loaders and new printed mechanism parts
    exma_common: design constants, STL/3MF/STEP loaders into the design frame
    (3MF boom/stick halves are the watertight sources; bucket STEP aligned to
    the STL at mean 0.15 mm).
    build-parts: CadQuery models + STEP/STL for boom/stick drums, bucket
    drum-axle, slew drum, slewing-ring retaining ring, conduit end fitting,
    three lever hubs, slew spool and wheel. All single watertight solids.
    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
    [2026-09-24-boom-drum.step, 2026-09-24-boom-drum.stl, 2026-09-24-bucket-drum-axle.step, 2026-09-24-bucket-drum-axle.stl, 2026-09-24-conduit-end-fitting.step, 2026-09-24-conduit-end-fitting.stl, 2026-09-24-lever-hub-boom.step, 2026-09-24-lever-hub-boom.stl]
2026-09-24 B3: modified EX-MA parts, PTFE routing, split clamps
    routing: PTFE tube centrelines built from lines/arcs (min bend R 19 mm,
    clears the boom pin by 8 mm and the stick pin by 7.5 mm, >= 1.65 mm of
    outer skin left beyond every tube channel).
    build-exma-mods: tower with circular flange (inner race) + tube clamp hub,
    lowered 13 mm; base with race rim, nut slots, centre hole; boom and stick
    halves with PTFE channels through internal ribs, stop bulkheads, drum
    key-screw sockets and M3 joining lugs; ears with hex sockets; bucket as
    one part (STEP body + bracket + lugs). All STLs watertight after reload;
    exterior deviation p99 <= 0.04 mm on boom/stick skin.
    build-parts: drum key screws, split pinch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
    [2026-09-24-base.stl, 2026-09-24-boom-drum.step, 2026-09-24-boom-drum.stl, 2026-09-24-boom-half-left.stl, 2026-09-24-boom-half-right.stl, 2026-09-24-bucket-ear-left.stl, 2026-09-24-bucket-ear-right.stl, 2026-09-24-bucket.stl]
2026-09-24 B4: assembly placement, joint sweeps, slewing-ring and cable validation
    assembly: places every part in the built pose; member groups for sweeps.
    cable-kinematics: joint contact sweeps, slewing ring fit/capture, PTFE
    tube checks over the working ranges (fixed-length tube model), travel
    table. Working ranges set by the lever slots (boom -40..45, stick -50..70,
    bucket -55..85); lever drums now Ø60 (40-52 deg lever swing); race
    clearance 0.15 mm.
    Open issue recorded in the report: PTFE tube path length through the
    stick joint changes 18-23 mm over the working range, which the arm
    cavities cannot absorb without kinking. Awaiting a routing decision.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
    [2026-09-24-base.stl, 2026-09-24-boom-drum.step, 2026-09-24-boom-half-left.stl, 2026-09-24-boom-half-right.stl, 2026-09-24-bucket-drum-axle.step, 2026-09-24-bucket-drum-axle.stl, 2026-09-24-bucket-ear-left.stl, 2026-09-24-bucket-ear-right.stl]
2026-09-24 EX-MA B4b: split pins, sliding PTFE tubes, conduit slack store
    - Boom/stick drums without pin bore, keyed by 2 x 2 M3 screws; split 8-32 pins
    leave the joint centres free so the tubes cross through the pivot axes.
    - Routing v3: balanced boom exit (55 deg) cuts the boom-joint length change to
    1.5 mm; tubes move to their own v-plane low in the tower (4.3 mm apart).
    - Tubes anchored in the box conduit fitting and at the arm stop bosses; they
    slide everywhere else. Spare length (<= 10.3 mm) coils in the conduit run
    (helix R >= 64). A tower bow was modelled and rejected (holds ~2.4 mm at R15).
    - Conduit fitting split into box (tube anchor) and pedestal (sliding) variants.
    - Tower: interna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
    [2026-09-24-base.stl, 2026-09-24-boom-drum.step, 2026-09-24-boom-drum.stl, 2026-09-24-boom-half-left.stl, 2026-09-24-boom-half-right.stl, 2026-09-24-bucket-ear-left.stl, 2026-09-24-bucket-ear-right.stl, 2026-09-24-bucket.stl]
2026-09-24 EX-MA B5: control box, pedestal and sandbox with validation
    - Measured hardware: 3/4in PEX-B turret tube (OD 22.23), 5/16in lever and
    spool axles, 1/2in copper OD 15.88. Tube slots re-placed inside the PEX
    bore; all B4b arm checks still pass.
    - Lever hubs: 5/16in bore, stacked 0.5 mm apart between two bearing blocks,
    M3 drag clamp per lever, tail anchors moved to the drum rear.
    - Slew: two-lane spool and pedestal drum (90-270 deg wrap over +-90 deg);
    each slew rope runs in a PTFE sleeve from a post beside the spool to an
    angled counterbore in the pedestal fitting aimed at the drum tangent.
    - Pedestal extended to u -110 (drum clears the fitting), shelf with a PEX
    bushing above the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
    [2026-09-24-boom-drum.step, 2026-09-24-bucket-drum-axle.step, 2026-09-24-conduit-end-fitting-box.step, 2026-09-24-conduit-end-fitting-box.stl, 2026-09-24-conduit-end-fitting-pedestal.step, 2026-09-24-conduit-end-fitting-pedestal.stl, 2026-09-24-conduit-end-fitting.step, 2026-09-24-conduit-end-fitting.stl]
2026-09-24 EX-MA B6: package - assembly STEP/GLB, A1 plates, BOM, reports
    - package.py: assembly STEP (exact B-rep: 108 solids, re-import checked;
    modified EX-MA mesh parts stay as placed STLs because sewn they reach
    ~420 MB), one-file GLB of every part with ropes and sleeves, automatic
    print orientation (least support, round parts axis-vertical), first-fit
    packing onto 7 Bambu A1 plates (3MF, reload + bed checks), and the
    bill of materials with counts computed from the models.
    - reports.py: inspection-and-architecture document (brief items 1-10,
    audit, mechanisms, constraints, directions, assembly order, decision
    log) and the validation roll-up (24/24 checks pass).
    - build-exma-mods: rec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
    [2026-09-24-ex-ma-assembly.step, 2026-09-24-plate-01.3mf, 2026-09-24-plate-02.3mf, 2026-09-24-plate-03.3mf, 2026-09-24-plate-04.3mf, 2026-09-24-plate-05.3mf, 2026-09-24-plate-06.3mf, 2026-09-24-plate-07.3mf]
2026-09-24 EX-MA B6b: hardware list uses the user's kits
    - BOM hardware grouped as: the Fgruh M3 kit (sizes up to M3 x 35, used vs
    in-kit counts, split-lock washers instead of lock nuts), the Hillman 8-32
    rod and nuts (joint pins only, jam nuts, 203 of 914 mm), the user's wood
    screws, and remaining stock (PTFE tube explained, rope, crimps, BBs ...).
    - Conduit fitting and box-to-sandbox bolts are M3 (x35 / x30 / x25);
    cut list and assembly notes updated to match.
    - Plain-language notes on what each screw group does.
    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
    [2026-09-24-control-box-wood.step, 2026-09-24-pedestal-wood.step, 2026-09-24-plate-01.3mf, 2026-09-24-plate-02.3mf, 2026-09-24-plate-03.3mf, 2026-09-24-plate-04.3mf, 2026-09-24-plate-05.3mf, 2026-09-24-plate-06.3mf]
2026-09-24 B7: continuous cable paths and review views 1-7
    - cable-paths.py builds one continuous 3D path per rope (8 tails/ropes, max gap 0 mm);
    rope and PTFE cut lengths now come from these measured paths
    - render-scene.py view set b7: 7 labelled review views rendered from the exported
    parts, wood and hardware, ropes coloured by circuit from the modelled paths
    - reports: review-view list in the architecture doc; rope-continuity row in the
    validation roll-up (25/25 pass)
    - BOM, box/kinematics reports and 3MF plates regenerated
    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
    [2026-09-24-plate-01.3mf, 2026-09-24-plate-02.3mf, 2026-09-24-plate-03.3mf, 2026-09-24-plate-04.3mf, 2026-09-24-plate-05.3mf, 2026-09-24-plate-06.3mf, 2026-09-24-plate-07.3mf]
2026-09-25 Full-assembly STEP builder (script) and report hooks
    - 2026-09-25-full-assembly.py: one STEP with every part; modified EX-MA meshes become exact
    B-rep solids (coplanar triangles merged into planar faces), ropes and PTFE tubes built from
    mitred straight pieces along the modelled paths; shipped as a zip (>100 MB unzipped)
    - reports.py lists the zip and adds its checks to the validation roll-up when present
    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
2026-09-25 Full assembly in one STEP file (zipped)
    - STEP/2026-09-25-ex-ma-full-assembly.zip: 131 solids (17 printed parts, 9 modified EX-MA parts
    as exact solids, 21 wood panels, 70 hardware items, 8 ropes, 6 PTFE tubes); 337 MB unzipped,
    64 MB zipped; all 131 solids re-import
    - Validation/2026-09-25-full-assembly-check.json; validation roll-up 27/27 pass
    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
2026-09-25 Printable with a 0.6 mm nozzle: solid stick nose and thin-wall fixes
    - stick halves: the original nose (0.3-0.4 mm hood over the bucket drum, a 6 mm open slot beside
    it, a 0.9 mm ring round the pin) becomes a solid rounded end inside the original r 12 outline,
    flush with each half's outer face; no support needed at the nose any more
    - bucket drum-axle flange lip 2.8 -> 1.8 mm so the nose hood is 2 mm thick (0.5 mm clearance)
    - stick root filled behind the side plate (key-pocket rims were 0.2-0.6 mm)
    - internal rib flakes left by the tube channels trimmed (boom and stick), clear of the outer skin
    - bucket: floor 1.8 mm (closes a crack through the old floor), lug slits, back-plate top edge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
    [2026-09-24-boom-drum.step, 2026-09-24-boom-half-left.stl, 2026-09-24-boom-half-right.stl, 2026-09-24-bucket-drum-axle.step, 2026-09-24-bucket-drum-axle.stl, 2026-09-24-bucket-ear-left.stl, 2026-09-24-bucket-ear-right.stl, 2026-09-24-bucket.stl]
2026-09-25 Full-assembly STEP zip rebuilt with the printable parts
    131 solids, all re-import; 334 MB unzipped, 63 MB zipped. Reports regenerated (28/28 pass).
    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
2026-09-25 Print and assembly checklist
    2026-09-25-print-and-assembly-checklist.md, generated by reports.checklist() from the same data as
    the BOM: tools, plate print order (build order) with a fit test per plate, stock cutting with
    labelled rope/PTFE lengths, build steps 4-11 each with its hardware and a check, rigging and
    tensioning, final function test. Every BOM hardware row is used in a step (checked).
    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
2026-09-25 Lever handles from 5/16in rod with printed knobs
    - handles: 5/16in smooth rod (3 x 230 mm) instead of 5/8in dowels, held in the lever hub
    socket (now 8.3 mm) by an M3 x 20 pinch clamp instead of a cross-pin
    - new printed part lever-knob (x3): 36 mm ball, glued on the rod (on plate 03)
    - lid slots narrowed to 9.0 mm and re-sized so they are still the hard stops (lever sweep passes)
    - BOM, cut list, checklist, wall check (26/26) updated; assembly STEP/zip, GLB and renders not rebuilt
    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
    [2026-09-24-control-box-wood.step, 2026-09-24-lever-hub-boom.step, 2026-09-24-lever-hub-boom.stl, 2026-09-24-lever-hub-bucket.step, 2026-09-24-lever-hub-bucket.stl, 2026-09-24-lever-hub-stick.step, 2026-09-24-lever-hub-stick.stl, 2026-09-24-lever-knob.step]
2026-09-25 Checklist: fit tests follow the repacked plates (drums on 03, knobs on 02/03)
    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
2026-09-27 Slicer project files with named plates for Bambu Studio and OrcaSlicer
    The loose trimesh plate files carried no slicer plate data, so the slicer
    split them across plates on its own. Replace them with two real projects
    (arm shell in PETG on one plate; everything else in PLA+ on plates grouped
    by build step), each written for Bambu Studio 2.8.2.61 and OrcaSlicer, with
    the user's A1 0.6 settings embedded. BOM and checklist follow the new plates
    and list the part count by group.
    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
    [2026-09-24-plate-01.3mf, 2026-09-24-plate-02.3mf, 2026-09-24-plate-03.3mf, 2026-09-24-plate-04.3mf, 2026-09-24-plate-05.3mf, 2026-09-24-plate-06.3mf, 2026-09-24-plate-07.3mf, 2026-09-27-bambu-arm-shell-petg.3mf]
2026-09-28 Faster print settings for the PLA+ slicer project
    At 0.3 mm layers with 0.62 mm lines, the SUNLU PLA+ 2.0 profile's 22 mm3/s
    flow cap held every line to about 118 mm/s. Raise it to 28 mm3/s at 230 C
    and let inner walls, infill and supports run at 200 mm/s with 10000 mm/s2
    acceleration; outer walls, top surfaces and the first layer are unchanged.
    The PETG arm-shell files are untouched.
    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
    [2026-09-27-bambu-other-parts-plaplus.3mf, 2026-09-27-orca-other-parts-plaplus.3mf]
2026-09-28 Solid-body assembly build scripts (mesh to B-rep, arm halves, hardware)
    New scripts for a full EX-MA assembly made of real solid bodies:
    - 2026-09-28-mesh-to-brep.py: watertight STL -> exact B-rep solid
    (planes, cylinders, cones, spheres; region edges on the surfaces'
    intersections; faces with a wrong area are rebuilt)
    - 2026-09-28-arm-halves-cad.py: boom / stick halves - original halves
    converted, build modifications redone as CAD booleans
    - 2026-09-28-solid-hardware.py: every fastener, pin, rod, BB, rope,
    PTFE tube and crimp as a placed solid
    - 2026-09-28-solid-assembly.py: builds, checks and zips the assembly
    (floor on Z = 0, footprint centred on X / Y = 0)
    No existing files ch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
2026-09-28 Compact control box spec (smallest box, no change to the arm)
    Markdown specification only (no models changed): box 214 x 362 x 156
    (was 250 x 405 x 242), 140 mm lever handles, 60 mm handle spacing,
    with the layout constants, rope and clearance checks, lid slots, panel
    and rod cut sizes, and the lever-feel trade-off.
    Claude-Session: https://claude.ai/code/session_01M8pzrdPgwRJ2nwYTjLTMoV
2026-09-28 Arm halves: more repair candidates for the STEP read-back check
    Adds small-face removal, face merging at 1 um and repair after read-back
    to export_checked(), and keeps the in-memory solid when every candidate
    fails. Lint-clean; not yet run end to end.
    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
2026-09-29 Reinforced bucket ears: solid joint between the ring and the lower block
    The ears' upper part met the lower block at one corner (0.4 mm across
    10 mm, one or two layers when printed on the side), with a void, a notch
    and a slit from the merged EX-MA shells around it. Adds a block on the
    outer side under the upper part (joint section 37-41 -> 144-145 mm2) and
    fills the two unused holes of the removed pins J/M. The inner diagonal
    (stick clearance) is unchanged.
    Checked: one watertight body each; bucket overlap unchanged; no new stick
    contact over the bucket sweep (-65..95 deg); the STEP files read back as
    one valid solid each (planes and cylinders).
    New files only; the 2026-09-24 ear STLs are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
    [2026-09-29-bucket-ear-left.step, 2026-09-29-bucket-ear-left.stl, 2026-09-29-bucket-ear-right.step, 2026-09-29-bucket-ear-right.stl]
2026-09-29 Base rebuilt as native CAD: one race cone, no support needed
    The base was the original EX-MA mesh with the race rim unioned on, so
    its STEP was a converted mesh and the 45 deg ball-race cone came out as
    flat facets. Rebuilt from its measured dimensions as one CadQuery solid
    (105 planes, 75 cylinders, 9 cones): the race is one conical face.
    Changes against the printed base:
    - 45 deg support under the race rim (was a 5.4 mm ledge over the outer
    pockets at z 15): overhang needing support 2848 -> 214 mm2 (the 8 nut
    slot roofs, 5.8 mm bridges).
    - the 4 unused r 62 mounting holes of the original base filled.
    - the small V groove at the rim joint closed; outer wall r 70.
    Everything that mates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
    [2026-09-29-base.step, 2026-09-29-base.stl, 2026-09-29-slewing-ring-retaining-ring.step, 2026-09-29-slewing-ring-retaining-ring.stl]
2026-09-29 Bucket ears rebuilt as native CAD (no mesh defects left)
    The patched ears (2026-09-29-bucket-ear-*.stl) still carried defects of
    the original EX-MA mesh: a crack at the knee, a hollow filled clip
    recess, slits in the lower block, a 0.14 mm step underneath and rings
    where the old pin holes were plugged. Both ears are now built from their
    measured design shape (one side profile extruded across the width, the
    ring with the hex socket, the bottom disc and pin), 24 faces each, with
    the same reinforced joint (145 mm2); the right ear is the exact mirror
    of the left about v = -0.07.
    Checked: one watertight body each, no slits in any section, STEP reads
    back as one valid solid, bucket overlap unchan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
    [2026-09-29-bucket-ear-left-cad.step, 2026-09-29-bucket-ear-left-cad.stl, 2026-09-29-bucket-ear-right-cad.step, 2026-09-29-bucket-ear-right-cad.stl]
2026-10-10 Illustrated assembly and configuration manual (PDF + editable sources)
    44-page Letter PDF: cover, contents, safety, system overview, parts
    identification (1:1 hardware, printed parts, wood), 12 assembly stages,
    operation, troubleshooting and appendices (BOM, drilling drawings,
    rope/tube reference, open items, compact-box option, files).
    Every illustration is rendered from the project CAD (STL parts, plywood
    panels, hardware solids, modelled rope paths); sources and build
    script included.
    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
2026-10-10 Wood cut list PDF (imperial): manual version + minimal no-conduit version
    Every plywood piece with cut sizes (inches to 1/16, mm alongside),
    4x8 sheet layouts with rip/crosscut order, and drilling drawings with
    standard bit sizes. Version B: compact control box, pedestal 1/2in
    shorter, and a 2-layer plywood spacer with 8-32 through-rods in place of
    the 2in PVC conduit (3-5/16in chamber keeps the PTFE tube slack).
    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
2026-10-11 Cut plan for the boards on hand (version B): 3 x 7/16in OSB 2x4, 5/8in particle board 2x2
    Sizes regenerated for 7/16in OSB and a 5/8in particle-board sandbox floor
    with no shim: pedestal and sandbox walls 5/32in shorter so the fittings stay
    aligned; elbow support loses its base plate. Board layouts, cut order,
    drilling and the derived rod/rope/tube lengths. Sheet size labels in the
    cut-list builder now follow the sheet.
    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
2026-10-11 Add minimal-build (no conduit) assembly manual with cut plan for 7/16in OSB + 5/8in particle board
    49-page PDF of the minimal design only: spacer frames and 8-32 through-rods
    replace the 2in PVC conduit; every cut size in inches; board layouts for the
    3 OSB 2x4 ft panels and the particle-board floor; drilling cards; ropes, PTFE
    and rods computed from the minimal CAD tree. Sources, rendered figures and a
    build script included; renderer gains spacer and particle-board colours.
    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
2026-10-29 Add solid-body STEP assembly script for the minimal design
    Runs the full-design solid-assembly pipeline on the minimal Source tree: no PVC
    conduit, spacer frames, 8-32 through-rods, sawn elbow support, kept 145 mm spool
    axle, 7/16in OSB and the 5/8in particle-board floor; 2026-09-29 base, ears and
    retaining ring.
    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
2026-10-29 Minimal assembly: STEP round-trip repair tool, README notes, zip-only mode
    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
2026-10-29 Minimal assembly: build groups bottom-up (CadQuery 2.8 copies sub-assemblies), validity before tessellation
    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
2026-10-29 Minimal design: solid-body STEP assembly zip (448 valid solids)
    2026-10-29-ex-ma-minimal-solid-assembly.zip: assembly STEP (mm, Z up), the nine
    EX-MA parts, the sawn elbow support, README with checks and build notes.
    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
